rundel-tech/ZARC/software/Notes.txt

cpm         CP/M 2.2 files and my disk image file extractor.
cpm/bios    CP/M BIOS. Intended to be loaded from memory card.
cpm/cpm_dev CP/M programmes written by me.
cpm/img_to_files    Extracts CP/M files from disk images.
cpm3        CP/M 3 files.
includes    ZARC include files.
monitor     ZARC monitor program.
tools       zmac and ld80 assembler and linker plus scripts.
