rundel-tech/ZARC/hardware/HardwareNotes.odt

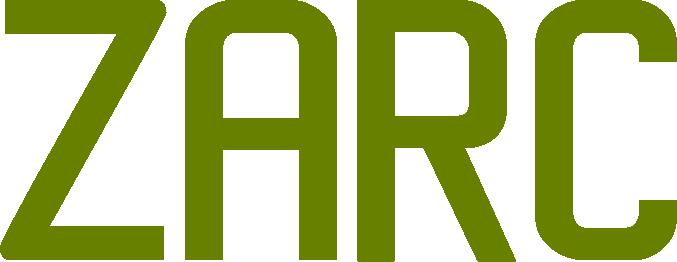
[picture p2: figure]
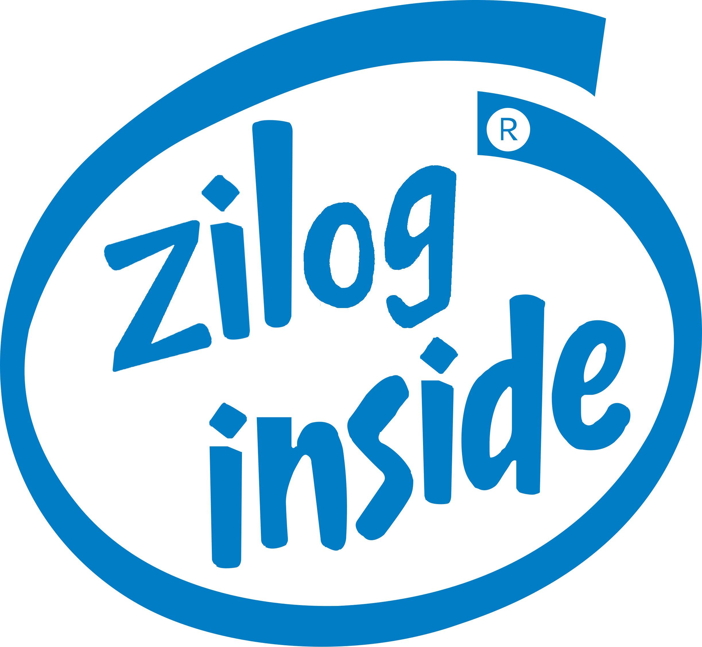
[picture p3: figure]

| ZARC HARDWARE DESIGN NOTES

Author: Merlin Skinner-Oakes

This is more of a log of the design process. See Users’ Guide for a description of the system as it stands.

# FRONT PANEL

Considering the DEC PDP-8/E, we have:

- SW - OMNIBUS SW line control. Influences some peripherals.
- Switch register bits 0 to 11.
- ADDR LOAD - sets PC to switch register
- EXTD ADDR LOAD - loads extended field information from SR6—11
- (START) CLEAR - clears the accumulator an other things, but not PC.
- (START) CONT - start machine running, or single step if SING STEP is down.
- EXAM - read current address and increment PC
- HALT - non biased, down is halted
- SING STEP
- DEP (biased down)

I think I'd need:

- Switch register bits 15 to 0
- ADDR LOAD - sets PC to switch register
- RESET - push
- FETCH - push
- STORE - push
- SINGLE - toggle - single step or run. Also affects fetch/store auto-increment.
- RUN - push
- STOP - push
- INT - push
- MEM/IO - toggle

# 11/2/2017

A simple idea. The front panel would look like this:

- 8 data switches
- Various mode switches
- Various status LEDs
- An "EXEC" momentary switch. This feeds an instruction (or data) to the CPU from the data switches.
- Address & date indicator LEDs

This would be a very flexible, but not so easy to use. To set the address to anything other than zero (reset), you would need to feed a "JMP" instruction or similar to the CPU. Hence we'd need to select 0xC3 on the switches, press EXEC, select the LSB, press EXEC then the MSB ... On the other hand, it would be a good debugging aid at a very low level.

Essentially this isn't so different to the Altair idea of loading the address by feeding a JMP to the CPU followed by the address. In this case, the 0xC3 was hard-coded. We could combine the two ideas by having the entire JMP instuction (24 bits) as switches. That's a lot of switches, though. It would mean that we couldn't inject 4-byte instructions, but that wouldn't be much of a limitation.

# 10/6/2017

Trying to get some idea of the case I'd require. Possibilities include:

- Farnell "Multicomp" G756AV (300 x 200 x 75 mm) - £17.01
- Farnell Pro-Power G17082UBK (431.8 x 203.2 x 86 mm) - £21.93

Both are available from Amazon slightly cheaper than Farnell.

To get a rough idea of size, I'd need at least 16 LEDs with switches underneath. Other switches could be in a second row.

Considering switch pitch. 15 mm seems reasonably "natural". Conventional keyboard pitch is about 18 to 19 mm. My PC keyboard appears to be about 18.9 mm pitch. My piano key pitch is 23.4 mm.

15 x piano pitch = 351 mm

15 x 18.9 = 283.5 mm

These rough measurements make the G756AV case look a little "cozy".

# 3/7/2017

CP/M can support up to 16 "banks", where the (usually) bottom 48 KBytes is paged with a common upper area. 16 x 64K is 1 MB. Looking in Farnell:

1562900 is a "AS6C4008-55PCN - SRAM, 4 Mbit, 512K x 8bit, 2.7V to 5.5V, DIP, 32 Pins, 55 ns"

Datasheet: https://www.alliancememory.com/wp-content/uploads/pdf/AS6C4008.pdf

Standby current: 4 μA (TYP.)!

We'd need two for a fully expanded system.

One possible idea is to page both 48K and 16K banks. CP/M would use a single 16K bank leaving fifteen of these for other purposes such as test areas, disk caches etc.

# 4/7/2017

This chip looks to do much of what I'd need, though I'd prefer to pull _WE and _OE high but it shouldn't really matter.

http://uk.farnell.com/analog-devices/adm691aanz/supervisor-circuit-mpu-1-dip-16/dp/2460086

Z80 Socket: http://uk.farnell.com/harwin/d2840-42/socket-ic-dil-40way-pk10/dp/1023063

# 5/7/2017

The upper 16K should be selectable from the 16 banks available, though for CP/M just one will be mapped permanently.

The remaining 48K should be selectable from the 16 banks and all are available to CP/M.

An alternate mode allows for any 16K bank to be mapped to the lower, or perhaps all four 16K banks of the Z80. This allows for initialisation on reset. Once running, the system can configure the memory as required.

On reset, the alternate mode is selected, mapping one of the 16K banks to the entire Z80 memory space. This facilitates startup code that is run on reset. Use of the 16K RAM banks allows this to be “hidden” from CP/M while allowing the full 16 x 48K pages to be accessible.

- Port n – lower (48K) RAM bank select (0 to 15)
- Port m – upper (16K) RAM bank select (0 to 15) plus overlay bit. Cleared on reset.

If the overlay bit is reset, the upper RAM bank is mapped to all four 16K Z80 spaces as “images”. In this case, port n contents are ignored.

# 9/7/2017

Interrupts and memory banks. I don't think we need to do anything special here. If we use a built-in vector, the software needs to maintain a copy in each of the banks. That's probably easier than a forced hardware bank selection. Having said that, the software could maintain a copy of the current bank in RAM, then use this to restore the state when the interrupt completes. This may conflict a bit with the "overlay bit" idea above so this may require further thought if I want to implement this.

Ideas for cases:

http://uk.rs-online.com/web/p/rack-fitting-cases-enclosures/0582877/ - ABS plastic

http://uk.rs-online.com/web/c/enclosures-storage-material-handling/19-inch-racking/rack-fitting-cases-enclosures/

http://uk.rs-online.com/web/p/rack-fitting-cases-enclosures/8104352/

# 13/10/2017

Front panel idea: Design panel for 16-bit address and data, though we’ll only be using the lowest 8 bits of data. Paging uses the same logic as the Z80 does, so the operator will need to write to the mapping register to access the entire memory. The advantages of this technique is that the panel will work for any CPU, and is probably simpler anyway than using the CPU as an address counter. It also means that the CPU and memory can be tightly coupled (with no intervening buffers) and hence fast if required.

Plan:

The front panel will have 16 address/data switches and its own address counter. If based on 74ls191 I have some already, though the '193 would be more convenient logically. The front panel switches would be something like:

- LAD (push) - Load ADdress
- + (push) - increment address
- - (push) - decrement address
- RD (push) - read location
- WR (push) - write locaton
- Mem / I/O (toggle) - memory / I/O space select

# 18/10/2017

Considering other switch types, such as On-Off-(On).

http://www.te.com/commerce/DocumentDelivery/DDEController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

The “F” series sound good. 6437630 is the core number for searching, variants have different prefixes and suffixes.

On-Off-(On) - 4-6437630-8 - £6.54

It all gets rather expensive. E-bay? Yes!

http://www.ebay.co.uk/itm/Momentary-On-Off-On-Mini-Small-Toggle-Switch-Car-Dash-SPDT-/281875674923

There are others of similar price. This could be handy for address inc/dec and read/write.

Memory mapping: 1 x 74ls670 could give us switching in 16 KB blocks. This would address up to 4 x 64 = 256 KB of memory in total. Conversely, adding a second ‘670 would allow up to 4 MB of memory, which may be a bit over the top.

Reset could be by means of disabling the ‘670 and forcing a constant onto the upper address bits (perhaps simply with resistors), until disabled in software.

# 6/12/2017

Considering 2 x 74hct374 (https://assets.nexperia.com/documents/data-sheet/74HC_HCT374_CNV.pdf) as paging registers.

- 3-state output enable time _OE to Q: 30 ns max. @ 25 °C
- 3-state output disable time _OE to Q: 30 ns max. @ 25 °C

One ‘374 represents the upper address bits for the lower 48 KB, and the other the upper 16 KB. Reset (and possibly interrupts) are catered for by disabling both registers and relying on pull-ups (or downs) to set the page until the software has initialised it properly.

OR

Use a single 8-bit register and a multiplexer (74hct157, https://assets.nexperia.com/documents/data-sheet/74HC_HCT157.pdf). This works out nicely as S can select upper 16 KB / lower 48 KB. _E forces all outputs low, so would be very handy for resets etc.

- S to nY – 25 ns max. @ 25 °C
- _E to nY – 23 ns max. @ 25 °C

OR

Use [1 or 2] x 74ls670 (still made by TI!) for very flexible mapping of each 16 Kb block to a [18 or 22]-bit address. This has the significant advantage that copies from one bank to another can be sped up by making them both “visible” at the same time.

- Read address to Q is 45 ns max.
- Read enable to Q is 40 ns max.

No “upper 16 KB/lower 48 KB detect” logic is required as we can use A14 & A15 directly. This will probably make this solution faster in overall propagation delay terms.

As above, the tri-state mode could be used for reset and perhaps interrupts. In the interrupt case, the previous page is maintained so we don’t need to be too clever with the software unless the interrupt routine requires access to something other than the default page. It is likely that the software would maintain a copy of the paging state in RAM in any case, so this may not be much of an issue.

# 2/5/2018 - Unusual Front Panel Idea

Rather than going for a more conventional address/data system, how about feeding data to the CPU from switches. Setting the address, for example, will require feeding the CPU a jump instruction followed by the address as if it were fetched from memory.

Controls are:

- 8 data - sets the corresponding data bit
- Clear - resets all data bits
- Run / Stop (toggle)
- Step - run one machine cycle (in stopped state)
- Data sel (toggle) - data fed to the CPU will be either from the switches or memory / I/O
- MemWrite - write switch data to memory at current address
- IOWrite - write switch data to I/O at current address
- NMI - non-maskable interrupt
- Reset - system reset (guarded?)

Notes

1. Data bus display shows memory or I/O data when data select is set to "normal". It shows the switch register data when set to "switches".
2. Machine stops at a M1 state (not an interrupt acknowledge) when "stop" is selected.

Writing to memory would involve:

- Set "Run / Stop" to "stop"
- Set "Data sel" to "Switches"
- Press "Clear"
- Set bits so data reads 0xc3 (JMP)
- Press "Step"
- Press "Clear"
- Set bits so data reads low byte of address
- Press "Step"
- Press "Clear"
- Set bits so data reads high byte of address
- Press "Step"
- Address bus shows the desired address.
- Press "Clear"
- Set bits so data as desired
- Press MemWrite (or IOWrite for I/O)

To select the next address, issue a "NOP":

- Press "Clear" (NOP is 0x00, so no data switches are required)
- Press "Step"

# 6/11/2018 (Tuesday)

How about ZARC – Z80 Advanced (Anachronistic?) Retro Computer?

# 27/7/2019 (Saturday)

To simplify the I/O, I have decided to implement it entirely within a Cyclone II FPGA development board. This device is limited to 3.3 V, however. As 74LVC245 devices (Farnell 1749756) are 5 V tolerant, these would form a nice easy bridge. My CMOS Z80 has a VIH of only 2.2 V (minimum), so there is plenty of margin with a 74LVC245 driven from 3.3 V.

# 30/7/2019 (Tuesday)

Video ideas:

- Use BBC Micro font expanded to 12 * 8 pixels. The original is here: https://damieng.com/blog/2011/02/20/typography-in-8-bits-system-fonts. This may help with any copyright issues as well as enhancing readability.
- Use video ram to contain cold boot code at power-on. Simple bootstrap code could read this, such as ld hl,0x0100; ld bc,00<port>; inir; halt. This gives up to 8 KB of bootstrap code! *1
- Rename DCClk to VRClk. It is convenient that this is a good speed for the video RAM. Odd cycles are for video, even for CPU / block copies etc.
- Hardware scrolling is automatically applied when the bottom line overflows.
- The hardware character cursor flashes the current location at about 1 Hz. This can be disabled in software.

*1 inir is limited to 256 bytes. One way around this is to use an initial loader that copies in the rest of the code. This should be plenty to do some BIST as well as boot from an MMC card.

# 14/1/2020 (Tuesday)

Super and Prot Bits

Implement a supervisor / user mode mechanism without adding much logic. The currently proposed system offers memory write protection in 16 KB blocks. This is reasonable protection against out-of-control or buggy software, but has obvious weaknesses. Nothing stops code writing to the memory mapping registers and disabling write protection, for example. In fact, all of the I/O is accessible to all software. This may cause issues if, for example, code written for another CP/M system is run on ZARC. Any I/O accesses by that code would have unknown effects on the completely different I/O architecture of ZARC.

The idea is that only 16 KB memory blocks with the "SUPER" bit (currently MA14) set would be allowed access to I/O. Each M1 cycle (instruction fetch), the SUPER bit is stored and acts as an I/O enable. Accesses to I/O when SUPER is low are blocked. By default, this results in a never-ending wait state and hence prevents system upset. The offending I/O address would be visible on the front panel. The step function of the front panel can be used to reveal the PC. Under software control, it is possible to modify this behaviour to prevent the system from being completely halted. In this alternate mode, I/O accesses are blocked as before, but the system is allowed to continue. An interrupt is generated to allow a supervising system to take the appropriate action. This is likely to be useful when running an operating system, so I/O functions such as disk accesses and console may be allowed to continue.

Writes to memory pages with the "PROT" bit set exhibit similar behaviour. By default, the system is halted. The offending address will then be visible on the front panel. Under software control, it is possible to modify this behaviour to prevent the system from being completely halted. In this alternate mode, offending writes are blocked as before, but the system is allowed to continue. An interrupt is generated to allow a supervising system to take the appropriate action.

The strategy is to simply halt the machine if something goes wrong until a monitor program or operating system is running. When running CP/M, only the upper 16 KB would normally have SUPER set. Hence user code is prevented from messing about with I/O other than through the BIOS. The BIOS runs in the upper 16 KB, and hence can access I/O.

Implementation could be the addition of a single flip-flop to capture the state of SUPER during an M1 cycle. The output of this is supplied to the FPGA, which includes this in the WAIT logic. Hence only one extra signal need cross the 5 V / 3 V domains.

# 18/3/2020 (Wednesday)

Wired clock generator circuit U7, U8 & U9. Measured Q10 of U9 and it was 30.517 Hz. This is exactly as calculated. Not bad for a probably 25 year old oscillator! Of course the meter ("Feedback FM610") is long out of calibration, but the correlation is remarkable.

Further to this, measuring U8 pin 3 (8 MHz) reads exactly 8.00000 MHz.

# 8/6/2020 (Monday)

I wired the two AA cells to the backup circuit a few days ago. After 2-3 days of no mains power, the capacitor voltage reads about 2.7 V. Voltage across the 220 Ohm battery series resistor is 6 mV, corresponding to a current of about 27 uA. Minimum backup voltage for the RAM is 1.5 V. That's a bit higher than I expected, but still very much OK.

For fun, I did some calculations in BackupSupply.ods. The battery life should be about 14 years at this consumption, but I'm sure other things will get to it first!

# Build

In the intervening period, the main board was built with a few changes along the way. The lockdown associated with COVID-19 certainly helped here.

# 19/2/2021 (Friday)

I've not made any hardware modifications for a long time. When I have been working on this, it is to add the MMC and RTC plus lots of software. Now CP/M runs! There are a few hardware modifications I am considering.

1) Change U43 to a CD74HCT373E (CPC part SC16201) to increase margins on switch inputs. Using an LS part here did not result in any issues, but this solution is better. Done.

2) Replace temporary D4 with a Schottky part (1N5817). Done.

3) Add a 1N5817 Schottky diode in series with D5 and D6 to reduce the brightness of the LEDs in DIM mode. Done.

4) Modify enables to MA<19..14> driver (U4) to disable it during I/O cycles, when the mapped address is not relevant. This simply moves U4 pin 1 from RFSH to _MREQ. Done.

5) Fix NEXT function. Relying on pull-down resistors on BD (U23) won't work because there are LS loads on the BD bus (74ls670). A better solution would be to switch SW_PD_COM with a transistor, thereby generating a 0x00 regardless of the data switch settings. Done.

# 24/4/2021 (Saturday)

Considering changes to the I/O FPGA. Two ideas are under consideration:

1. Hardware CRC. The primary purpose is to speed up memory card I/O.
2. NMI is currently not useable in CP/M mode as CP/M uses the vector (0x0066) as part of default FCB 1. A solution would be useful to avoid crashes if the NMI features are used.

## Hardware CRC

This would be relatively straightforward, and would take up only a small part of the FPGA. There is some advantage to keeping this separate from the memory card I/O system so it may be used for other applications within ZARC. Essentially, from a software point of view, the current monitor crc16x (CRC-16 – XMODEM) function call would be replaced by a single OUT instruction. However, it would not offer any advantage over the present implementation beyond speeding up memory card I/O. It is something to consider when next making changes to the FPGA.

## NMI Memory Mapping (Idea)

It is unfortunate that CP/M overwrites the NMI vector. This makes the PROT, SUPER, trace and front panel NMI switch all unusable when CP/M is running. Worse, any NMI will cause a jump to the unpredictable contents of FCB and therefore almost certainly cause a crash. One way to avoid this would be to select a different page when the NMI is serviced. This is not straightforward. There are two main issues as I see it:

1. Detection of NMI processing (interrupt acknowledge).
2. Control of memory paging logic.

The Z80 generates a clearly distinguishable acknowledge cycle for interrupts (_IORQ with _M1). Unfortunately, this is not true for NMI. The acknowledge cycle is simply a normal instruction fetch, but with the memory contents discarded. However, since an NMI is always actioned at the end of the instruction in which it occurs, careful timing of the assertion of NMI with respect to M1 cycles should enable the logic to ascertain which cycle is currently in progress.

The FPGA cannot change the memory mapping, only enable or disable it (the _MMAP_EN signal). Disabling the mapping forces the page is use to be 0x3f for all four banks. Write protection is also active in this state. Any solution must allow the saving of the PC on the stack to proceed unmolested.

The Z80’s response to an NMI is to stack the PC, then fetch the first instruction of the NMI handler from address 0x0066 (http://www.z80.info/zip/z80-interrupts_rewritten.pdf section 3).

Considering one possible scheme:

1. Synchronise the assertion of NMI with the current machine cycle state so that the NMI is actioned at a predictable point.
2. Enable memory mapping for writes, but disable it for reads. Execution proceeds from page 0x3f location 0x0066, but writes go to the application-selected page. This permits the two stack writes (PC) plus any PUSH instructions to proceed uninhibited.
3. Software sets up the monitor memory map, moves the stack to the monitor’s variables page and enables normal memory mapping operation.

The NMI handler must take care to save all relevant context information while protecting its environment. A candidate NMI handler may start like this:

; Jump at 0x0066 goes here. Writes will go to the application-selected bank

; until normal operation is selected in this code. We should try to minimise

; writes until this point as it will go on the application stack.

default_nmi push af ; To application stack

; Save memory mapping context before we change anything.

in IOA_MMAP_0

ld (user_mmap_0), a

in IOA_MMAP_1

ld (user_mmap_1), a

in IOA_MMAP_2

ld (user_mmap_2), a

in IOA_MMAP_3

ld (user_mmap_3), a

; Setup bank 0 and bank 1 for the monitor.

; Set bank 0 (0x0000 to 0x3fff) as read-only with I/O access.

ld a, MMAP_MON_B0_PAGE + MMAP_PROT_MASK + MMAP_SUPER_MASK

out (IOA_MMAP_0), a

; Bank 1 (0x4000 to 0x7fff) writeable.

ld a, MMAP_MON_B1_PAGE

out (IOA_MMAP_1), a

; Enable normal memory mapping. This disables the NMI mode read / write

; differentiation in operation until now.

ld a, SYSCTRL_MMAP_MASK

out (IOA_CONTROL), a

; Set stack to exception area so we can save the registers.

ld (user_sp), SP ; Save SP

ld SP, XPT_STACK_TOP + 1

[ Save CPU registers. PC and AF will require some work as these are on the user

stack on an arbitrary location.]

A running CP/M system could reasonably locate the stack in any of the four banks at some point. It should be possible to handle this and allow debugging of any bank using the proposed system. This would allow debugging of any part of the CP/M system, for example.

While making these changes, it would seem reasonable to modify the monitor to use just two banks (0 and 1). The proposed memory mapping is therefore:

; 0 (0000 - 3FFF): 3f read only, supervisor - monitor program

; 1 (4000 - 7FFF): 3e writeable - monitor variables, buffers etc.

; 2 (8000 - BFFF): (not used)

; 3 (C000 - FFFF): (not used)

The complications caused by interrupts make it sensible to only allow these in user code. This allows the monitor to be free of common banks with the user code. Simplifying its operating environment may improve reliability too.

The above code also assumes a change to the system control register (IOA_CONTROL) register. At the moment, we have (from io_map.i):

BITDEF SYSCTRL_MMAP, 0 ; “1” enables memory mapping

BITDEF SYSCTRL_TRARM, 1 ; “1” arms the trace interrupt

Add a single extra bit:

BITDEF SYSCTRL_NMI_MAP, 2 ; NMI mode memory mapping

This is set by hardware on NMI, and reset by software to restore normal operation.

# 9/6/2021 (Wednesday)

I have implemented something akin to the context switching ideas discussed in the previous entry. This allows debugging without the debugger appearing in the Z80 memory space of the target programme. There are limitations, of course, but this will allow debugging of any part of CP/M or a transient programme running under it.

Using the new technique allows the monitor to load an entire 64 K from the memory card. To achieve this requires something like:

> set mmap 1 ; If not already enabled

> map

0 (0000 - 3FFF): 00 writeable ; Map should look like this

1 (4000 - 7FFF): 01 writeable

2 (8000 - BFFF): 02 writeable

3 (C000 - FFFF): 03 writeable

> readsec 0 128 0

> dump 0 ; Reasonableness check

0000 FA B8 00 10 8E D0 BC 00 |........|

0008 B0 B8 00 00 8E D8 8E C0 |........|

0010 FB BE 00 7C BF 00 06 B9 |...|....|

0018 00 02 F3 A4 EA 21 06 00 |.....!..|

0020 00 BE BE 07 38 04 75 0B |....8.u.|

0028 83 C6 10 81 FE FE 07 75 |.......u|

0030 F3 EB 16 B4 02 B0 01 BB |........|

0038 00 7C B2 80 8A 74 01 8B |.|...t..|

The read takes about ten seconds in all. This currently uses a software CRC for the data transfers. There are other inefficiencies, such as copying involved in maintaining the cache and between memory spaces.

As changes to the FPGA were required to implement the new NMI and context switching mechanisms, it seemed a good time to add a hardware CRC block. Using the hardware CRC, the above 64 KB load is achieved in 8.5 seconds. Further improvements could be achieved by optimising the SPI transfer code, which is currently not optimised for speed.

Note for both of the measurements above, the cache was effectively flushed beforehand by reading sectors outside of the test range:

> readsec 256 128 0

# 26/6/2021 (Saturday)

The intended behaviour of the MMC interface was to initialise at 250 kHz, then switch to 4 MHz for normal operation. While looking at ways to optimise the sector read code (read_block in mmc.z80), I discovered a bug that prevented the switch to higher speed, so we were running at 250 kHz throughout. Fixing this bug caused errors during initialisation. Further reading of the MMC specification reveals that 400 kHz is the maximum speed in “Identification Mode (OD)”. The only way to switch from identification mode to data transfer mode is with “CMD 3” (SET_RELATIVE_ADDR), which is not available in SPI mode. It would appear, therefore, that 400 kHz is the maximum speed we can use, and would explain the errors encountered when operating at 4 MHz.

I plan to modify the FPGA firmware to run at 400 kHz in slow mode even though I doubt this will make much difference to the system performance as a whole. High speed mode may yet be useful for future peripherals and doesn’t involve much extra logic, so I will leave that alone.

Playing with figures in Calculations.ods reveals that even at 250 kHz the maximum theoretical loading time for 64 KB would be about 2.4 seconds, though this makes no allowance for command transfers, copying from cache and other overheads. At 400 kHz this reduces to 1.4 seconds. Either is plenty fast enough for ZARC and definitely faster than floppy disks due in part to much lower overheads (track stepping etc.).

# 29/6/2021 (Tuesday)

I have changed the FPGA to run SPI at 400 kHz in slow mode. The read_block code in mmc.z80 has been updated to allow processing and SPI interface to run in parallel. Now a 64 KB read (readsec 0 128 0) takes about 6.4 seconds from the monitor. This was originally ten. I suspect a good part of this time is the monitor copy code and status messages. Copying from cache to memory is particularly inefficient as the appropriate page and mapping is carried out for each and every byte. This could clearly be improved, but transfer speed in the monitor is not a priority. CP/M disk logging seems noticeably faster, however.
