rundel-tech/ZARC/fpga/Pinout.ods

Demo Board Pinout
P1 | FPGA pin | FPGA Signal | Bank | Demo Board | ZARC Signal
1 | 40 | DEV_OE / IO | 4 |  | N/C
2 | 41 | IO | 4 |  | LV_D1
3 | 42 | IO | 4 |  | LV_D0
4 | 43 | IO | 4 |  | LV_D3
5 | 44 | IO | 4 |  | LV_D2
6 | 45 | IO | 4 |  | LV_D5
7 | 47 | IO | 4 |  | LV_D4
8 | 48 | IO | 4 |  | LV_D7
9 | 51 | IO | 4 |  | LV_D6
10 | 52 | IO | 4 |  | LV_A1
11 | 53 | IO | 4 |  | LV_A0
12 | 55 | IO | 4 |  | LV_A3
13 | 57 | IO | 4 |  | LV_A2
14 | 58 | IO | 4 |  | LV_A5
15 | 59 | IO | 4 |  | LV_A4
16 | 60 | IO | 4 |  | LV_A7
17 | 63 | IO | 4 |  | LV_A6
18 | 64 | IO | 4 |  | \_LV_M1\_
19 | 65 | IO | 4 |  | \_LV_IORQ\_
20 | 67 | IO | 4 |  | \_LV_MREQ\_
21 | 69 | IO | 4 |  | \_LV_WR\_
22 | 70 | IO | 4 |  | \_LV_RD\_
23 | 71 | IO | 4 |  | LV_SUPER
24 | 72 | IO | 4 |  | LV_PROT
25 | GND |  |  |  | GND
26 | GND |  |  |  | GND
27 | VCC3.3 |  |  |  | P3V3
28 | VCC3.3 |  |  |  | P3V3
P2 | FPGA pin | FPGA Signal | Bank |  | ZARC Signal
1 | GND |  |  |  | GND
2 | GND |  |  |  | GND
3 | 73 | IO | 3 | R13/C14 network | N/C
4 | 74 | IO | 3 |  | N/C
5 | 75 | IO | 3 |  | \_LV_NMI_SWITCH\_
6 | 76 | nCEO | 3 |  | N/C
7 | 79 | IO | 3 |  | LV_RESET
8 | 80 | IO | 3 | GND via R9 [0Ω] | N/C
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
