rundel-tech/ZARC/hardware/BackupSupply.ods

Supercapacitor Charging
Assuming a charge from 12 V via a resistor, to avoid the diode drop from the 5 V supply.
1 | Capacitor value (F)
12 | Charging source voltage
5 | Nominal capacitor voltage
0.65 | Diode drop in charging circuit
1000 | Charging resistor
0.01135 | Initial charge current
0.00635 | Terminal charge current
0.00885 | Average charging current
5 | Capacitor charge (Coulombs)
564.971751412429 | Charging time (s)
9.41619585687382 | Above in minutes
0.1288225 | Initial power dissipation in resistor (W)
0.0403225 | Terminal power dissipation in resistor (W)
12.5 | Energy stored (J)
Discharging
0.425 | DS1672 VBACKUP Current (Oscillator On) (µA typical)
4 | AS6C4008-55PCN static RAM (µA typical)
2 | MCP1702 3.3 V regulator (µA typical)
1 | Supercapacitor leakage (4 µA typical for a similar type, or 1 µA/F at room temperature "rule of thumb")
0.008 | 1n4148 diode leakage at 25 °C
11.441 | Total (µA typical)
1.1441E-05 | Above in A
1.5 | Minimum backup voltage. RTC will run down to 1.3 V
1.5 | Charge left at this voltage
3.5 | Useable charge (Coulombs)
305917.314920024 | Backup time in s
5098.62191533374 | Above in minutes
84.977031922229 | Above in hours
3.54070966342621 | Above in days
27 | Current draw measured on 8/6/2020. RTC not fitted yet, so just the RAM and regulator etc. (µA)
2.7E-05 | Above in A
Battery Life
Cells are “Duracell Plus Power”
Found a datasheet here: https://images-eu.ssl-images-amazon.com/images/I/91w564JQWRS.pdf
650 | hours at 5mA load (the lowest load they specify) to 0.8 V
2340000 | Above in s
0.005 | 5 mA in A
11700 | Charge (Coulombs)
433333333.333333 | Seconds of life at current measured on 8/6/2020
7222222.22222222 | Above in minutes
120370.37037037 | Above in hours
5015.43209876543 | Above in days
13.7409098596313 | Above in years
