rundel-tech/ZARC/hardware/Calculations.ods

Reset time constant
This is very approximate as I haven’t looked up the 74hc14 thresholds.
1 | C in μF
1E-09 | Above in F
10000 | R
1E-05 | Time constant (s)
10 | Above in μs
CPU Cycle Timings
CPU is a Z84C0010PEG (10 MHz)
Datasheet Parameter | Value (ns) | Description
 | 55 | RAM access time (ns)
8 | 55 | Clock fall to _MREQ fall delay (max.)
17 | 20 | _Wait setup to clock fall (min.)
18 | 10 | _Wait hold after clock fall (min.)
27 | 50 | Clock rise to _IORQ fall (max.)
51 | 55 | Clock fall to _IORQ fall delay (max.)
15 | 25 | Data setup to clock rise (min.)
25 | 25 | Data setup to clock fall during M2, M3, M4 or M5 cycles (min.)
10 MHz | 8 MHz | 4 MHz
100 | 125 | 250 | Clock period (ns)
25 | 50 | 175 | _MREQ fall to _WAIT setup (M1 cycle or mem. R/W)
80 | 117.5 | 305 | _IORQ fall to _WAIT setup (I/O cycle)
25 | 50 | 175 | _IORQ fall to _WAIT setup (interrupt acknowledge cycle)
70 | 107.5 | 295 | _MREQ fall to data setup (M1 cycle)
15 | 52.5 | 240 | Above less RAM access time (decoding time)
120 | 170 | 420 | _MREQ fall to data setup (memory read cycle)
65 | 115 | 365 | Above less RAM access time (decoding time)
175 | 237.5 | 550 | _IORQ fall to data setup (I/O read cycle)
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
