rundel-tech/ZARC/hardware/FrontPanel/FrontPanel.ods

Considering the size of the front panel
25.4 | mm per inch
46 | Panel height (internal)
378 | Panel width (internal). This allows for the handles etc.
Switches
23.5 | Typical piano key spacing (mm)
22.86 | Switch spacing (multiple of 0.1”)
5 | Space at each end
17.0979877515311 | Switches per row (maximum)
Count | Type | Legend(s) | Function
8 | Toggles | D7 – D0 | 8 data bits
1 | Toggle | Man / Norm | Data sel (toggle) - data fed to the CPU will be either from the switches or memory / I/O
1 | Push | Write | Write - write switch data to memory at current address (memory or I/O)
1 | Push | Next | As below, but feeds a NOP to the CPU to increment the address
1 | Push | Step | Step - run one machine cycle (in stopped state)
1 | Toggle | Run / Stop | Run / Stop
1 | Push | NMI | NMI - non-maskable interrupt
1 | Push | Reset | Reset - system reset
15 | Number of switches
330.04 | Total space required if all were in a line.
LEDs
22.86 | LED spacing
5 | Space at each end
16.0979877515311 | LEDs per row (maximum)
Count | Legend(s) | Function
16 | A15 – A0
7 | MA20 – MA14 | Mapped address
1 | PROT | Write protection
8 | D7 – D0
1 | RESET
1 | HALT
1 | NMI
1 | INT
1 | M1
1 | MREQ
1 | IORQ
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
