rundel-tech/ZARC/software/cpm/cpm_dev/fsck/README.md

# CP/M File System Consistency Checker
“FSCK” is an abbreviation for File System Consistency checK), as commonly found on Unix and Linux systems. This programme scans a CP/M 2.2 or CP/M 3 file system and reports any errors it finds. It does not attempt any kind of repair. Though written for my ZARC retro-computer project, this should run on any CP/M system. Simply copy [FSCK.COM](FSCK.COM) to a disk and run it. For further information, see [fsckGuide.pdf](fsckGuide.pdf).
