rundel-tech/ZARC/hardware/FrontPanel/Panel.png

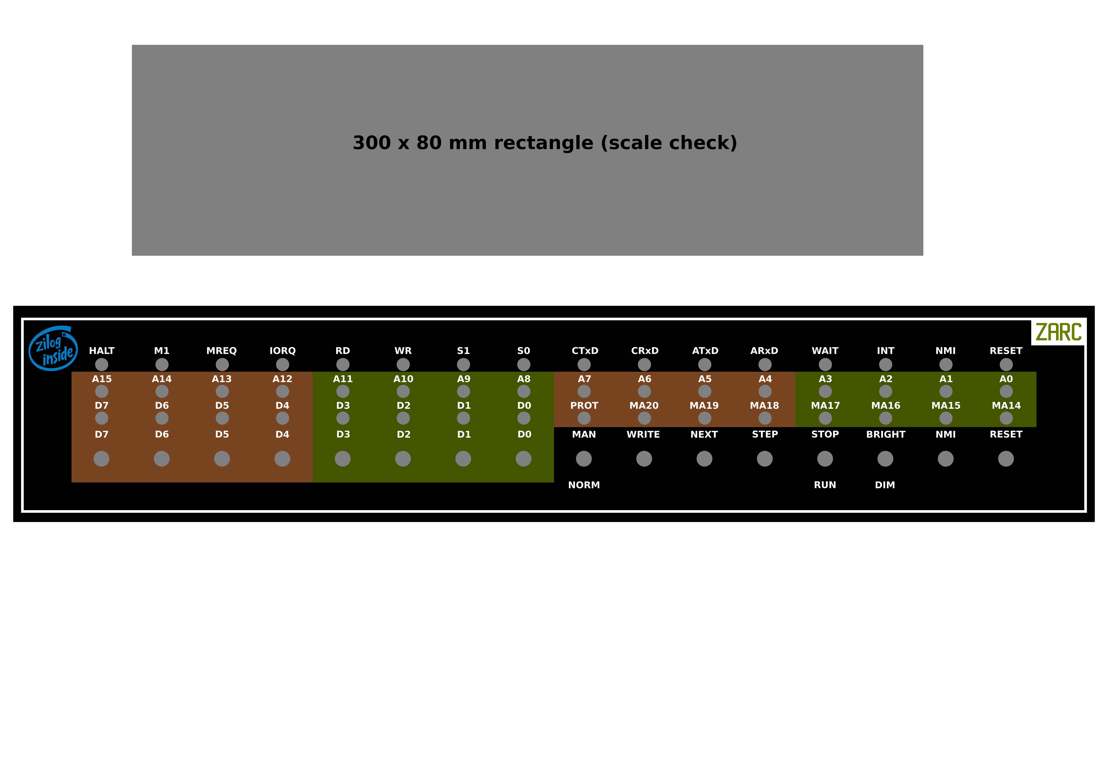
hardware/FrontPanel/Panel.png
