rundel-tech/ZARC/hardware/CAD/Main/Archive/netlist_wired.ods

Tracking Wiring Progress
18/04/20 |  | Merlin Skinner
Imported from “netlist.txt”
0 | Number of nets yet to be wired
353 | Number of wired nets
100.00% | Nets complete
1065 | Total nodes
0 | Number of nodes yet to be wired
100.00% | Nodes complete
 |  | START | nets
State | Not Conn. | Name | Count | To Do
Done | N/C | unnamed_net151 | 1 | 0 | J1 | B7
Done | N/C | unnamed_net150 | 1 | 0 | J1 | B5
Done | N/C | unnamed_net149 | 1 | 0 | J1 | B3
Done | N/C | unnamed_net148 | 1 | 0 | J1 | A5
Done | N/C | unnamed_net147 | 1 | 0 | J1 | A3
Done | N/C | unnamed_net146 | 1 | 0 | J1 | B6
Done | N/C | unnamed_net145 | 1 | 0 | J1 | B4
Done | N/C | unnamed_net144 | 1 | 0 | J1 | B2
Done | N/C | unnamed_net143 | 1 | 0 | J1 | A6
Done | N/C | unnamed_net142 | 1 | 0 | J1 | A4
Done | N/C | unnamed_net141 | 1 | 0 | J1 | A2
Done |  | LV_A7 | 2 | 0 | J1 | B31, | U33 | 11
Done |  | LV_A6 | 2 | 0 | J1 | A31, | U33 | 12
Done |  | LV_A5 | 2 | 0 | J1 | B30, | U33 | 13
Done |  | LV_A4 | 2 | 0 | J1 | A30, | U33 | 14
Done |  | LV_A3 | 2 | 0 | J1 | B29, | U33 | 15
Done |  | LV_A2 | 2 | 0 | J1 | A29, | U33 | 16
Done |  | LV_A1 | 2 | 0 | J1 | B28, | U33 | 17
Done |  | LV_A0 | 2 | 0 | J1 | A28, | U33 | 18
Done |  | LV_PROT | 2 | 0 | J1 | A19, | U13 | 11
Done |  | LV_SUPER | 2 | 0 | J1 | A18, | U13 | 12
Done |  | \_LV_WR\_ | 2 | 0 | J1 | A17, | U13 | 13
Done |  | \_LV_RD\_ | 2 | 0 | J1 | A16, | U13 | 14
Done |  | \_LV_IORQ\_ | 2 | 0 | J1 | A15, | U13 | 15
Done |  | \_LV_MREQ\_ | 2 | 0 | J1 | A14, | U13 | 16
Done |  | \_LV_M1\_ | 2 | 0 | J1 | A13, | U13 | 17
Done |  | LV_CPU_CLK | 2 | 0 | J1 | A11, | U13 | 18
Done |  | unnamed_net140 | 2 | 0 | R57 | 1, | U3 | 11
Done |  | unnamed_net139 | 2 | 0 | R53 | 1, | U3 | 12
Done |  | unnamed_net138 | 2 | 0 | R56 | 1, | U3 | 13
Done |  | unnamed_net137 | 2 | 0 | R52 | 1, | U3 | 14
Done |  | unnamed_net136 | 2 | 0 | R55 | 1, | U3 | 15
Done |  | unnamed_net135 | 2 | 0 | R51 | 1, | U3 | 16
Done |  | unnamed_net134 | 2 | 0 | R54 | 1, | U3 | 17
Done |  | unnamed_net133 | 2 | 0 | R50 | 1, | U3 | 18
Done |  | unnamed_net132 | 2 | 0 | R49 | 1, | U2 | 11
Done |  | unnamed_net131 | 2 | 0 | R45 | 1, | U2 | 12
Done |  | unnamed_net130 | 2 | 0 | R48 | 1, | U2 | 13
Done |  | unnamed_net129 | 2 | 0 | R44 | 1, | U2 | 14
Done |  | unnamed_net128 | 2 | 0 | R47 | 1, | U2 | 15
Done |  | unnamed_net127 | 2 | 0 | R43 | 1, | U2 | 16
Done |  | unnamed_net126 | 2 | 0 | R46 | 1, | U2 | 17
Done |  | unnamed_net125 | 2 | 0 | R42 | 1, | U2 | 18
Done |  | unnamed_net124 | 2 | 0 | R41 | 1, | U1 | 11
Done |  | unnamed_net123 | 2 | 0 | R37 | 1, | U1 | 12
Done |  | unnamed_net122 | 2 | 0 | R40 | 1, | U1 | 13
Done |  | unnamed_net121 | 2 | 0 | R36 | 1, | U1 | 14
Done |  | unnamed_net120 | 2 | 0 | R39 | 1, | U1 | 15
Done |  | unnamed_net119 | 2 | 0 | R35 | 1, | U1 | 16
Done |  | unnamed_net118 | 2 | 0 | R38 | 1, | U1 | 17
Done |  | unnamed_net117 | 2 | 0 | R34 | 1, | U1 | 18
Done |  | \_S0\_ | 2 | 0 | R61 | 2, | U1 | 9
Done |  | \_S1\_ | 2 | 0 | R61 | 3, | U1 | 8
Done |  | LED_D0 | 2 | 0 | R50 | 2, | J2 | 26
Done |  | LED_D1 | 2 | 0 | R54 | 2, | J2 | 25
Done |  | LED_D2 | 2 | 0 | R51 | 2, | J2 | 24
Done |  | LED_D3 | 2 | 0 | R55 | 2, | J2 | 23
Done |  | LED_D4 | 2 | 0 | R52 | 2, | J2 | 22
Done |  | LED_D5 | 2 | 0 | R56 | 2, | J2 | 21
Done |  | LED_D6 | 2 | 0 | R53 | 2, | J2 | 20
Done |  | LED_D7 | 2 | 0 | R57 | 2, | J2 | 19
Done |  | LED_A8 | 2 | 0 | R42 | 2, | J2 | 18
Done |  | LED_A9 | 2 | 0 | R46 | 2, | J2 | 17
Done |  | LED_A10 | 2 | 0 | R43 | 2, | J2 | 16
Done |  | LED_A12 | 2 | 0 | R44 | 2, | J2 | 15
Done |  | LED_A13 | 2 | 0 | R48 | 2, | J2 | 14
Done |  | LED_A14 | 2 | 0 | R45 | 2, | J2 | 13
Done |  | LED_A15 | 2 | 0 | R49 | 2, | J2 | 12
Done |  | LED_A11 | 2 | 0 | R47 | 2, | J2 | 11
Done |  | LED_S0 | 2 | 0 | R41 | 2, | J2 | 10
Done |  | LED_S1 | 2 | 0 | R37 | 2, | J2 | 9
Done |  | LED_WR | 2 | 0 | R40 | 2, | J2 | 8
Done |  | LED_RD | 2 | 0 | R36 | 2, | J2 | 7
Done |  | LED_IORQ | 2 | 0 | R39 | 2, | J2 | 6
Done |  | LED_MREQ | 2 | 0 | R35 | 2, | J2 | 5
Done |  | LED_M1 | 2 | 0 | R38 | 2, | J2 | 4
Done |  | LED_HALT | 2 | 0 | R34 | 2, | J2 | 3
Done |  | unnamed_net116 | 2 | 0 | R24 | 1, | U5 | 11
Done |  | unnamed_net115 | 2 | 0 | R20 | 1, | U5 | 12
Done |  | unnamed_net114 | 2 | 0 | R23 | 1, | U5 | 13
Done |  | unnamed_net113 | 2 | 0 | R19 | 1, | U5 | 14
Done |  | unnamed_net112 | 2 | 0 | R22 | 1, | U5 | 15
Done |  | unnamed_net111 | 2 | 0 | R18 | 1, | U5 | 16
Done |  | unnamed_net110 | 2 | 0 | R21 | 1, | U5 | 17
Done |  | unnamed_net109 | 2 | 0 | R17 | 1, | U5 | 18
Done |  | unnamed_net108 | 2 | 0 | R16 | 1, | U4 | 11
Done |  | unnamed_net107 | 2 | 0 | R12 | 1, | U4 | 12
Done |  | unnamed_net106 | 2 | 0 | R15 | 1, | U4 | 13
Done |  | unnamed_net105 | 2 | 0 | R11 | 1, | U4 | 14
Done |  | unnamed_net104 | 2 | 0 | R14 | 1, | U4 | 15
Done |  | unnamed_net103 | 2 | 0 | R10 | 1, | U4 | 16
Done |  | unnamed_net102 | 2 | 0 | R13 | 1, | U4 | 17
Done |  | unnamed_net101 | 2 | 0 | R9 | 1, | U4 | 18
Done |  | unnamed_net100 | 2 | 0 | R32 | 1, | U6 | 11
Done |  | unnamed_net99 | 2 | 0 | R28 | 1, | U6 | 12
Done |  | unnamed_net98 | 2 | 0 | R31 | 1, | U6 | 13
Done |  | unnamed_net97 | 2 | 0 | R27 | 1, | U6 | 14
Done |  | unnamed_net96 | 2 | 0 | R30 | 1, | U6 | 15
Done |  | unnamed_net95 | 2 | 0 | R26 | 1, | U6 | 16
Done |  | unnamed_net94 | 2 | 0 | R29 | 1, | U6 | 17
Done |  | unnamed_net93 | 2 | 0 | R25 | 1, | U6 | 18
Done |  | \_ARxD\_ | 2 | 0 | R33 | 6, | U6 | 5
Done |  | \_ATxD\_ | 2 | 0 | R33 | 7, | U6 | 4
Done |  | \_CRxD\_ | 2 | 0 | R33 | 8, | U6 | 3
Done |  | \_CTxD\_ | 2 | 0 | R33 | 9, | U6 | 2
Done |  | LED_RESET | 2 | 0 | R32 | 2, | J3 | 24
Done |  | LED_NMI | 2 | 0 | R28 | 2, | J3 | 23
Done |  | LED_INT | 2 | 0 | R31 | 2, | J3 | 22
Done |  | LED_WAIT | 2 | 0 | R27 | 2, | J3 | 21
Done |  | LED_ARxD | 2 | 0 | R30 | 2, | J3 | 20
Done |  | LED_ATxD | 2 | 0 | R26 | 2, | J3 | 19
Done |  | LED_CRxD | 2 | 0 | R29 | 2, | J3 | 18
Done |  | LED_CTxD | 2 | 0 | R25 | 2, | J3 | 17
Done |  | LED_A0 | 2 | 0 | R17 | 2, | J3 | 16
Done |  | LED_A1 | 2 | 0 | R21 | 2, | J3 | 15
Done |  | LED_A2 | 2 | 0 | R18 | 2, | J3 | 14
Done |  | LED_A3 | 2 | 0 | R22 | 2, | J3 | 13
Done |  | LED_A4 | 2 | 0 | R19 | 2, | J3 | 12
Done |  | LED_A5 | 2 | 0 | R23 | 2, | J3 | 11
Done |  | LED_A6 | 2 | 0 | R20 | 2, | J3 | 10
Done |  | LED_A7 | 2 | 0 | R24 | 2, | J3 | 9
Done |  | LED_MA14 | 2 | 0 | R9 | 2, | J3 | 8
Done |  | LED_MA15 | 2 | 0 | R13 | 2, | J3 | 7
Done |  | LED_MA16 | 2 | 0 | R10 | 2, | J3 | 6
Done |  | LED_MA17 | 2 | 0 | R14 | 2, | J3 | 5
Done |  | LED_MA18 | 2 | 0 | R11 | 2, | J3 | 4
Done |  | LED_MA19 | 2 | 0 | R15 | 2, | J3 | 3
Done |  | LED_SUPER | 2 | 0 | R12 | 2, | J3 | 2
Done |  | LED_PROT | 2 | 0 | R16 | 2, | J3 | 1
Done |  | unnamed_net92 | 2 | 0 | U15 | 10, | U15 | 11
Done |  | unnamed_net91 | 2 | 0 | U15 | 4, | U15 | 3
Done |  | unnamed_net90 | 3 | 0 | U14 | 10, | U15 | 2, | R7 | 2
Done |  | unnamed_net89 | 4 | 0 | U32 | 3, | U15 | 12, | U15 | 1, | R6 | 2
Done |  | PROT | 4 | 0 | U13 | 9, | U4 | 9, | R8 | 9, | U25 | 6
Done |  | SUPER | 4 | 0 | U13 | 8, | U4 | 8, | R8 | 8, | U25 | 7
Done |  | unnamed_net88 | 3 | 0 | U14 | 8, | U25 | 4, | U24 | 4
Done |  | unnamed_net87 | 3 | 0 | U14 | 6, | U25 | 5, | U24 | 5
Done |  | unnamed_net86 | 3 | 0 | U14 | 4, | U25 | 13, | U24 | 13
Done |  | unnamed_net85 | 3 | 0 | U14 | 2, | U25 | 14, | U24 | 14
Done | N/C | unnamed_net84 | 1 | 0 | U34 | 23
Done |  | \_HALT\_ | 4 | 0 | R61 | 9, | U1 | 2, | U32 | 2, | U34 | 18
Done |  | A15 | 4 | 0 | R59 | 9, | U2 | 9, | U14 | 9, | U34 | 5
Done |  | A14 | 4 | 0 | R59 | 8, | U2 | 8, | U14 | 5, | U34 | 4
Done |  | A13 | 5 | 0 | R59 | 7, | U2 | 7, | U14 | 11, | U15 | 13, | U34 | 3
Done |  | \_RAM_CS1\_ | 2 | 0 | U15 | 6, | U36 | 22
Done |  | MA19 | 5 | 0 | U4 | 7, | R8 | 7, | U25 | 9, | U36 | 1, | U35 | 1
Done |  | MA18 | 5 | 0 | U4 | 6, | R8 | 6, | U25 | 10, | U36 | 30, | U35 | 30
Done |  | MA17 | 5 | 0 | U4 | 5, | R8 | 5, | U24 | 6, | U36 | 2, | U35 | 2
Done |  | MA16 | 5 | 0 | U4 | 4, | R8 | 4, | U24 | 7, | U36 | 31, | U35 | 31
Done |  | D3 | 6 | 0 | U23 | 5, | R60 | 5, | U3 | 5, | U34 | 8, | U36 | 17, | U35 | 17
Done |  | D4 | 6 | 0 | U23 | 6, | R60 | 6, | U3 | 6, | U34 | 7, | U36 | 18, | U35 | 18
Done |  | D5 | 6 | 0 | U23 | 7, | R60 | 7, | U3 | 7, | U34 | 9, | U36 | 19, | U35 | 19
Done |  | D6 | 6 | 0 | U23 | 8, | R60 | 8, | U3 | 8, | U34 | 10, | U36 | 20, | U35 | 20
Done |  | D7 | 6 | 0 | U23 | 9, | R60 | 9, | U3 | 9, | U34 | 13, | U36 | 21, | U35 | 21
Done |  | \_RAM_CS0\_ | 2 | 0 | U15 | 8, | U35 | 22
Done |  | A10 | 5 | 0 | R59 | 4, | U2 | 4, | U34 | 40, | U36 | 23, | U35 | 23
Done |  | A11 | 5 | 0 | R59 | 5, | U2 | 5, | U34 | 1, | U36 | 25, | U35 | 25
Done |  | A9 | 5 | 0 | R59 | 3, | U2 | 3, | U34 | 39, | U36 | 26, | U35 | 26
Done |  | A8 | 5 | 0 | R59 | 2, | U2 | 2, | U34 | 38, | U36 | 27, | U35 | 27
Done |  | MA14 | 5 | 0 | U4 | 2, | R8 | 2, | U24 | 10, | U36 | 28, | U35 | 28
Done |  | D2 | 6 | 0 | U23 | 4, | R60 | 4, | U3 | 4, | U34 | 12, | U36 | 15, | U35 | 15
Done |  | D1 | 6 | 0 | U23 | 3, | R60 | 3, | U3 | 3, | U34 | 15, | U36 | 14, | U35 | 14
Done |  | D0 | 6 | 0 | U23 | 2, | R60 | 2, | U3 | 2, | U34 | 14, | U36 | 13, | U35 | 13
Done |  | A0 | 7 | 0 | U33 | 2, | R58 | 2, | U5 | 2, | U14 | 1, | U34 | 30, | U36 | 12, | U35 | 12
Done |  | A1 | 7 | 0 | U33 | 3, | R58 | 3, | U5 | 3, | U14 | 3, | U34 | 31, | U36 | 11, | U35 | 11
Done |  | A2 | 6 | 0 | U33 | 4, | R58 | 4, | U5 | 4, | U34 | 32, | U36 | 10, | U35 | 10
Done |  | A3 | 6 | 0 | U33 | 5, | R58 | 5, | U5 | 5, | U34 | 33, | U36 | 9, | U35 | 9
Done |  | A4 | 6 | 0 | U33 | 6, | R58 | 6, | U5 | 6, | U34 | 34, | U36 | 8, | U35 | 8
Done |  | A5 | 6 | 0 | U33 | 7, | R58 | 7, | U5 | 7, | U34 | 35, | U36 | 7, | U35 | 7
Done |  | A6 | 6 | 0 | U33 | 8, | R58 | 8, | U5 | 8, | U34 | 36, | U36 | 6, | U35 | 6
Done |  | A7 | 6 | 0 | U33 | 9, | R58 | 9, | U5 | 9, | U34 | 37, | U36 | 5, | U35 | 5
Done |  | A12 | 5 | 0 | R59 | 6, | U2 | 6, | U34 | 2, | U36 | 4, | U35 | 4
Done |  | MA15 | 5 | 0 | U4 | 3, | R8 | 3, | U24 | 9, | U36 | 3, | U35 | 3
Done | N/C | unnamed_net83 | 1 | 0 | U7 | 12
Done | N/C | unnamed_net82 | 1 | 0 | U38 | 11
Done | N/C | unnamed_net81 | 1 | 0 | U32 | 11
Done |  | unnamed_net80 | 2 | 0 | D6 | 2, | D5 | 1
Done |  | -12V | 2 | 0 | J1 | B1, | J6 | B3
Done | N/C | unnamed_net79 | 1 | 0 | J6 | B2
Done | N/C | unnamed_net78 | 1 | 0 | J5 | B4
Done | N/C | unnamed_net77 | 1 | 0 | U11 | 5
Done |  | \_MREQ_NV\_ | 3 | 0 | U15 | 9, | U15 | 5, | U11 | 12
Done | N/C | unnamed_net76 | 1 | 0 | U11 | 14
Done | N/C | unnamed_net75 | 1 | 0 | U11 | 6
Done | N/C | unnamed_net74 | 1 | 0 | U11 | 10
Done | N/C | unnamed_net73 | 1 | 0 | U11 | 8
Done | N/C | unnamed_net72 | 1 | 0 | U11 | 7
Done | N/C | unnamed_net71 | 1 | 0 | U11 | 11
Done |  | RAM_VCC | 6 | 0 | C7 | 2, | U36 | 32, | C6 | 2, | U35 | 32, | U11 | 2, | C4 | 2
Done |  | unnamed_net70 | 3 | 0 | U11 | 1, | U44 | 3, | C3 | 1
Done |  | unnamed_net69 | 2 | 0 | B2 | 1, | B1 | 2
Done |  | unnamed_net68 | 2 | 0 | R2 | 1, | B1 | 1
Done |  | unnamed_net67 | 2 | 0 | R2 | 2, | D3 | 1
Done |  | unnamed_net66 | 5 | 0 | U44 | 2, | C1 | 2, | C2 | 1, | D3 | 2, | D2 | 2
Done |  | unnamed_net65 | 3 | 0 | D1 | 1, | D2 | 1, | R1 | 1
Done |  | +12V | 3 | 0 | J1 | A1, | J6 | B4, | R1 | 2
Done |  | \_INT\_ | 4 | 0 | R33 | 4, | U6 | 7, | U34 | 16, | U40 | 8
Done |  | IO_BUF_DIR | 3 | 0 | J1 | A20, | U23 | 1, | U32 | 8
Done |  | \_LV_IO_BUF_EN\_ | 2 | 0 | J1 | A21, | U32 | 6
Done |  | \_IO_BUF_EN\_ | 2 | 0 | U23 | 19, | U30 | 3
Done |  | \_MMAP_EN\_ | 4 | 0 | J1 | B8, | U25 | 11, | U24 | 11, | R5 | 8
Done |  | \_MMAP_IO_SEL\_ | 4 | 0 | J1 | A7, | U25 | 12, | U24 | 12, | R5 | 7
Done |  | POW_RST | 2 | 0 | U11 | 16, | R5 | 6
Done |  | \_LV_PNL_DAT_RD\_ | 3 | 0 | U30 | 4, | R5 | 4 | J1 | B7
Done |  | \_LV_INT\_ | 3 | 0 | U40 | 9, | R5 | 2 | J1 | A6
Done |  | +3.3V | 9 | 0 | J1 | A27, | J1 | A32, | J1 | A22, | J1 | A12, | U33 | 1, | U13 | 1, | D4 | 2, | J5 | B2, | R5 | 1
Done |  | \_NMI\_ | 4 | 0 | R33 | 3, | U6 | 8, | U34 | 17, | U42 | 11
Done |  | \_LV_NMI\_ | 3 | 0 | R5 | 3, | U42 | 13 | J1 | B6
Done |  | unnamed_net64 | 2 | 0 | U32 | 4, | U20 | 8
Done |  | unnamed_net63 | 2 | 0 | U30 | 2, | U20 | 9
Done |  | \_WR\_ | 6 | 0 | U13 | 7, | R61 | 4, | U1 | 7, | U34 | 22, | U32 | 9, | U20 | 2
Done | N/C | unnamed_net62 | 1 | 0 | U20 | 6
Done |  | unnamed_net61 | 2 | 0 | U32 | 10, | U20 | 5
Done |  | \_MREQ\_ | 6 | 0 | U13 | 4, | R61 | 7, | U1 | 4, | U34 | 19, | U11 | 13, | U21 | 5
Done |  | \_IORQ\_ | 6 | 0 | U13 | 5, | R61 | 6, | U1 | 5, | U34 | 20, | U20 | 12, | U21 | 4
Done |  | LV_IOWAIT | 3 | 0 | J1 | A8, | R5 | 5, | U42 | 5
Done |  | \_M1\_ | 5 | 0 | U13 | 3, | R61 | 8, | U1 | 3, | U34 | 27, | U31 | 3
Done |  | RFSH | 9 | 0 | U2 | 19, | U3 | 19, | U3 | 1, | U2 | 1, | U5 | 19, | U5 | 1, | U4 | 19, | U4 | 1, | U31 | 2
Done |  | \_RFSH\_ | 3 | 0 | U32 | 1, | U34 | 28, | U31 | 1
Done |  | PRE_WAIT | 3 | 0 | U42 | 6, | U42 | 9, | U41 | 2
Done |  | \_WAIT\_ | 4 | 0 | R33 | 5, | U6 | 6, | U34 | 24, | U41 | 6
Done | N/C | unnamed_net60 | 1 | 0 | U41 | 5
Done |  | \_FPGA_BUF_INH\_ | 2 | 0 | U32 | 5, | U31 | 12
Done |  | DO_WRITEORNEXT | 2 | 0 | U18 | 6, | U18 | 2
Done |  | unnamed_net59 | 4 | 0 | U19 | 9, | U19 | 10, | U19 | 13, | U30 | 11
Done |  | unnamed_net58 | 2 | 0 | U40 | 11, | U39 | 2
Done |  | \_RAM_WE\_ | 3 | 0 | U36 | 29, | U35 | 29, | U40 | 6
Done |  | DO_STEPORNEXT | 4 | 0 | U18 | 12, | U18 | 8, | U19 | 12, | U40 | 5
Done |  | unnamed_net57 | 2 | 0 | U19 | 8, | U40 | 4
Done |  | \_PNL_LATCH_OE_RQ\_ | 2 | 0 | U30 | 5, | U40 | 3
Done |  | \_RAM_OE\_ | 3 | 0 | U36 | 24, | U35 | 24, | U42 | 3
Done |  | \_RD\_ | 6 | 0 | U13 | 6, | R61 | 5, | U1 | 6, | U34 | 21, | U31 | 11, | U42 | 2
Done |  | unnamed_net56 | 3 | 0 | U31 | 13, | U39 | 8, | U42 | 1
Done |  | unnamed_net55 | 2 | 0 | U39 | 11, | U19 | 5
Done |  | \_PNL_IO_BUF_EN\_ | 3 | 0 | U30 | 1, | U40 | 1, | U19 | 6
Done |  | unnamed_net54 | 2 | 0 | U18 | 3, | U39 | 5
Done |  | USE_PNL_DATA | 3 | 0 | U19 | 4, | U39 | 9, | U39 | 6
Done |  | \_DO_D\_ | 3 | 0 | U39 | 13, | U30 | 13, | U29 | 14
Done | N/C | unnamed_net53 | 1 | 0 | U29 | 11
Done | N/C | unnamed_net52 | 1 | 0 | U29 | 6
Done | N/C | unnamed_net51 | 1 | 0 | U29 | 3
Done |  | unnamed_net50 | 2 | 0 | U39 | 3, | U29 | 13
Done |  | DO_C | 3 | 0 | U30 | 12, | U39 | 1, | U29 | 10
Done |  | DO_B | 3 | 0 | U39 | 12, | U29 | 12, | U29 | 7
Done |  | DO_A | 3 | 0 | U39 | 10, | U29 | 5, | U29 | 2
Done |  | unnamed_net49 | 2 | 0 | U18 | 11, | U29 | 4
Done |  | RD | 3 | 0 | U31 | 10, | U39 | 4, | U21 | 10
Done |  | M1 | 2 | 0 | U31 | 4, | U21 | 13
Done |  | PNL_WAIT | 2 | 0 | U42 | 4, | U28 | 13
Done |  | DO_WRITE | 4 | 0 | U40 | 12, | U18 | 13, | U18 | 4, | U28 | 9
Done |  | CYCLE | 3 | 0 | U20 | 10, | U31 | 6, | U28 | 15
Done |  | \_DO_CYCLE\_ | 2 | 0 | U19 | 11, | U28 | 14
Done |  | DO_STEP | 2 | 0 | U18 | 10, | U28 | 7
Done |  | DO_NEXT | 4 | 0 | U18 | 9, | U18 | 5, | U40 | 2, | U28 | 4
Done |  | \_PNL_OP_DONE\_ | 4 | 0 | U30 | 8, | U28 | 5, | U28 | 10, | U28 | 1
Done |  | \_DO_E\_ | 2 | 0 | U30 | 9, | U27 | 14
Done | N/C | unnamed_net48 | 1 | 0 | U27 | 15
Done |  | DO_D | 2 | 0 | U29 | 15, | U27 | 13
Done | N/C | unnamed_net47 | 1 | 0 | U27 | 10
Done | N/C | unnamed_net46 | 1 | 0 | U27 | 7
Done | N/C | unnamed_net45 | 1 | 0 | U27 | 2
Done |  | unnamed_net44 | 3 | 0 | U21 | 8, | U27 | 12, | U38 | 9
Done |  | unnamed_net43 | 2 | 0 | U27 | 11, | U38 | 10
Done |  | unnamed_net42 | 3 | 0 | U28 | 12, | U28 | 11, | U38 | 8
Done |  | unnamed_net41 | 2 | 0 | U27 | 6, | U38 | 5
Done |  | unnamed_net40 | 2 | 0 | U28 | 6, | U38 | 6
Done |  | unnamed_net39 | 3 | 0 | U21 | 11, | U27 | 4, | U38 | 1
Done |  | unnamed_net38 | 2 | 0 | U27 | 3, | U38 | 2
Done |  | unnamed_net37 | 3 | 0 | U28 | 3, | U28 | 2, | U38 | 3
Done |  | \_CYCLE\_ | 5 | 0 | U21 | 6, | U42 | 10, | U31 | 5, | U40 | 13, | U41 | 11
Done | N/C | unnamed_net36 | 1 | 0 | U41 | 9
Done |  | unnamed_net35 | 2 | 0 | U41 | 10, | U19 | 3
Done |  | \_RUN\_ | 4 | 0 | U40 | 10, | U42 | 12, | U41 | 8, | U21 | 1
Done |  | NEXT | 2 | 0 | U21 | 12, | U26 | 9
Done |  | unnamed_net34 | 2 | 0 | U26 | 6, | U26 | 8
Done |  | unnamed_net33 | 2 | 0 | U7 | 6, | U26 | 7
Done |  | STEP | 3 | 0 | U27 | 5, | U38 | 4, | U26 | 5
Done |  | MAN | 2 | 0 | U18 | 1, | U26 | 19
Done |  | unnamed_net32 | 2 | 0 | U26 | 18, | U26 | 16
Done |  | unnamed_net31 | 2 | 0 | U7 | 8, | U26 | 17
Done |  | WRITE | 2 | 0 | U21 | 9, | U26 | 15
Done |  | unnamed_net30 | 2 | 0 | U26 | 14, | U26 | 12
Done |  | unnamed_net29 | 2 | 0 | U7 | 10, | U26 | 13
Done |  | unnamed_net28 | 2 | 0 | U21 | 3, | U26 | 1
Done |  | unnamed_net27 | 2 | 0 | U26 | 2, | U26 | 4
Done |  | unnamed_net26 | 2 | 0 | U7 | 4, | U26 | 3
Done |  | NMI_SWITCH | 2 | 0 | J1 | A9, | U16 | 9
Done |  | unnamed_net25 | 2 | 0 | U16 | 6, | U16 | 8
Done |  | unnamed_net24 | 2 | 0 | U7 | 2, | U16 | 7
Done |  | \_RESET\_ | 8 | 0 | J1 | B9, | R33 | 2, | U6 | 9, | U34 | 26, | U30 | 10, | U29 | 1, | U27 | 1, | U16 | 5
Done | N/C | unnamed_net23 | 1 | 0 | U16 | 19
Done |  | \_STOP_2\_ | 3 | 0 | U41 | 13, | U19 | 2, | U16 | 16
Done |  | \_STOP_1\_ | 4 | 0 | U41 | 12, | U16 | 17, | U19 | 1, | U16 | 15
Done |  | unnamed_net22 | 2 | 0 | U16 | 14, | U16 | 12
Done |  | \_POW_RST\_ | 3 | 0 | U11 | 15, | U21 | 2, | U16 | 1
Done |  | unnamed_net21 | 2 | 0 | U16 | 2, | U16 | 4
Done |  | PNL_LATCH_EN | 2 | 0 | U42 | 8, | U43 | 11
Done |  | BD7 | 5 | 0 | J1 | B26, | R62 | 2, | U23 | 11, | U25 | 3, | U43 | 19
Done |  | BD6 | 5 | 0 | J1 | A26, | R62 | 3, | U23 | 12, | U25 | 2, | U43 | 16
Done |  | BD5 | 5 | 0 | J1 | B25, | R62 | 4, | U23 | 13, | U25 | 1, | U43 | 15
Done |  | BD4 | 5 | 0 | J1 | A25, | R62 | 5, | U23 | 14, | U25 | 15, | U43 | 12
Done |  | BD3 | 5 | 0 | J1 | B24, | R62 | 6, | U23 | 15, | U24 | 3, | U43 | 9
Done |  | BD2 | 5 | 0 | J1 | A24, | R62 | 7, | U23 | 16, | U24 | 2, | U43 | 6
Done |  | BD1 | 5 | 0 | J1 | B23, | R62 | 8, | U23 | 17, | U24 | 1, | U43 | 5
Done |  | BD0 | 5 | 0 | J1 | A23, | R62 | 9, | U23 | 18, | U24 | 15, | U43 | 2
Done |  | \_PNL_LATCH_OE\_ | 2 | 0 | U30 | 6, | U43 | 1
Done |  | \_SW_RESET_NO\_ | 3 | 0 | R4 | 8, | U16 | 3, | J4 | 24
Done | N/C | \_SW_RESET_NC\_ | 1 | 0 | J4 | 23
Done |  | \_SW_NMI_NO\_ | 3 | 0 | U7 | 1, | R4 | 7, | J4 | 22
Done | N/C | \_SW_NMI_NC\_ | 1 | 0 | J4 | 21
Done |  | LED_PWR | 7 | 0 | J2 | 2, | J2 | 1, | J3 | 26, | J3 | 25, | R63 | 2, | D6 | 1, | J4 | 20
Done |  | \_SW_STOP\_ | 3 | 0 | R4 | 6, | U16 | 13, | J4 | 18
Done |  | \_SW_STEP_NO\_ | 3 | 0 | U7 | 3, | R4 | 5, | J4 | 17
Done | N/C | \_SW_STEP_NC\_ | 1 | 0 | J4 | 16
Done |  | \_SW_NEXT_NO\_ | 3 | 0 | U7 | 5, | R4 | 4, | J4 | 15
Done | N/C | \_SW_NEXT_NC\_ | 1 | 0 | J4 | 14
Done |  | \_SW_WRITE_NO\_ | 3 | 0 | U7 | 11, | R4 | 3, | J4 | 13
Done | N/C | \_SW_WRITE_NC\_ | 1 | 0 | J4 | 12
Done |  | \_SW_MAN\_ | 3 | 0 | U7 | 9, | R4 | 2, | J4 | 11
Done |  | Vcc | 32 | 0 | J1 | B10, | J1 | A10, | R61 | 1, | U1 | 20, | R33 | 1, | U6 | 20, | R8 | 1, | U34 | 11, | U34 | 25, | D5 | 2, | D4 | 1, | C8 | 1, | J5 | B3, | U11 | 3, | C5 | 2, | D1 | 2, | U20 | 13, | U20 | 14, | U20 | 4, | U20 | 1, | U41 | 4, | U41 | 1, | U29 | 16, | U27 | 16, | U41 | 14, | R4 | 1, | U26 | 20, | U16
Done |  | SW_PD0 | 3 | 0 | U43 | 3, | R3 | 2, | J4 | 8
Done |  | SW_PD1 | 3 | 0 | U43 | 4, | R3 | 3, | J4 | 7
Done |  | SW_PD2 | 3 | 0 | U43 | 7, | R3 | 4, | J4 | 6
Done |  | SW_PD3 | 3 | 0 | U43 | 8, | R3 | 5, | J4 | 5
Done |  | SW_PD4 | 3 | 0 | U43 | 13, | R3 | 6, | J4 | 4
Done |  | SW_PD5 | 3 | 0 | U43 | 14, | R3 | 7, | J4 | 3
Done |  | SW_PD6 | 3 | 0 | U43 | 17, | R3 | 8, | J4 | 2
Done |  | SW_PD7 | 3 | 0 | U43 | 18, | R3 | 9, | J4 | 1
Done |  | CPU_CLK_B | 7 | 0 | U13 | 2, | U20 | 11, | U20 | 3, | U41 | 3, | U29 | 9, | U27 | 9, | U31 | 8
Done |  | CPU_CLK | 2 | 0 | U34 | 6, | U14 | 12
Done | N/C | unnamed_net20 | 1 | 0 | U9 | 9
Done | N/C | unnamed_net19 | 1 | 0 | U9 | 10
Done | N/C | unnamed_net18 | 1 | 0 | U9 | 11
Done | N/C | unnamed_net17 | 1 | 0 | U10 | 1
Done |  | PNL_CLK | 3 | 0 | U26 | 11, | U16 | 11, | U10 | 15
Done | N/C | unnamed_net16 | 1 | 0 | U10 | 14
Done | N/C | unnamed_net15 | 1 | 0 | U10 | 12
Done | N/C | unnamed_net14 | 1 | 0 | U10 | 13
Done | N/C | unnamed_net13 | 1 | 0 | U10 | 4
Done | N/C | unnamed_net12 | 1 | 0 | U10 | 2
Done | N/C | unnamed_net11 | 1 | 0 | U10 | 3
Done | N/C | unnamed_net10 | 1 | 0 | U10 | 5
Done | N/C | unnamed_net9 | 1 | 0 | U10 | 6
Done | N/C | unnamed_net8 | 1 | 0 | U10 | 7
Done | N/C | unnamed_net7 | 1 | 0 | U10 | 9
Done |  | unnamed_net6 | 2 | 0 | U9 | 8, | U10 | 10
Done |  | VCC | 26 | 0 | U33 | 20, | U13 | 20, | U23 | 20, | U3 | 20, | U2 | 20, | U5 | 20, | U4 | 20, | U15 | 14, | U25 | 16, | U24 | 16, | U32 | 14, | U18 | 14, | U30 | 14, | U40 | 14, | U42 | 14, | U39 | 14, | U28 | 16, | U38 | 14, | U7 | 14, | U19 | 14, | U21 | 14, | U31 | 14, | U8 | 14, | U14 | 14, | U10 | 16, | U9 | 14
Done |  | unnamed_net5 | 2 | 0 | U9 | 13, | U9 | 6
Done | N/C | unnamed_net4 | 1 | 0 | U9 | 5
Done |  | GND | 91 | 0 | J1 | B11, | J1 | B21, | J1 | B20, | J1 | B19, | J1 | B18, | J1 | B17, | J1 | B16, | J1 | B15, | J1 | B14, | J1 | B13, | J1 | B27, | J1 | B32, | J1 | B22, | J1 | B12, | U33 | 10, | U33 | 19, | U13 | 10, | U13 | 19, | R62 | 1, | U23 | 10, | R60 | 1, | R59 | 1, | R58 | 1, | U3 | 10, | U2 | 10, | U1 | 10, | U1 | 19, | U1
Done | N/C | unnamed_net3 | 1 | 0 | U9 | 4
Done |  | unnamed_net2 | 2 | 0 | U8 | 8, | U9 | 1
Done |  | unnamed_net1 | 3 | 0 | U31 | 9, | U14 | 13, | U9 | 3
 |  | END | nets
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
