rundel-tech/ZARC/(list of files, cad)

Other CAD files:
fpga/Firmware/output_files/stp1_auto_stripped.stp
fpga/Firmware/output_files/stp1.stp
fpga/Firmware/output_files/AllPins.stp
fpga/Firmware/output_files/SPI_Debug_auto_stripped.stp
fpga/Firmware/output_files/Trace_auto_stripped.stp
fpga/Firmware/output_files/AllPins_auto_stripped.stp
fpga/Firmware/output_files/I2C_Debug_auto_stripped.stp
fpga/Firmware/output_files/Interrupts_auto_stripped.stp
fpga/Firmware/output_files/I2C_Debug.stp
fpga/Firmware/output_files/Trace.stp
fpga/Firmware/output_files/Interrupts.stp
fpga/Firmware/output_files/SPI_Debug.stp
fpga/Firmware/simulation/modelsim/rtl_work/asyncser_rx/logic.psm
fpga/Firmware/simulation/modelsim/rtl_work/asyncser_tx/logic.psm
fpga/Firmware/simulation/modelsim/rtl_work/crc16_xmodem/logic.psm
fpga/Firmware/simulation/modelsim/rtl_work/definitions/_vhdl.psm
fpga/Firmware/simulation/modelsim/rtl_work/denoise/logic.psm
fpga/Firmware/simulation/modelsim/rtl_work/fifo_ram/syn.psm
fpga/Firmware/simulation/modelsim/rtl_work/fifos/logic.psm
fpga/Firmware/simulation/modelsim/rtl_work/i2c_master/logic.psm
fpga/Firmware/simulation/modelsim/rtl_work/intcontrol/logic.psm
fpga/Firmware/simulation/modelsim/rtl_work/main/logic.psm
fpga/Firmware/simulation/modelsim/rtl_work/mainpll/syn.psm
fpga/Firmware/simulation/modelsim/rtl_work/nmi_control/logic.psm
fpga/Firmware/simulation/modelsim/rtl_work/outexpander/logic.psm
fpga/Firmware/simulation/modelsim/rtl_work/spi_master/logic.psm
fpga/Firmware/simulation/modelsim/rtl_work/sync2ff/logic.psm
fpga/Firmware/simulation/modelsim/rtl_work/timing/logic.psm
fpga/Firmware/simulation/modelsim/rtl_work/trace_pre_tb/beh.psm
