rundel-tech/ZARC/software/cpm/cpm_dev/fsck/fsckGuide.odt

| fsck Users’ Guide

Written by Merlin Skinner-Oakes, 1/11/2022

Last updated: 19/2/2023

# Revision History

1 – initial release (fsck V1.0)

2 – updated to include “/s” option (fsck V1.1).

3 – added section #4.

4 – updated for fsck V1.3 (mainly CP/M 3 support).

5 – updated for fsck V1.4 (make command line case insensitive to ease use with replacement CCPs).

# Description

“FSCK” is an abbreviation for File System Consistency checK), as commonly found on Unix and Linux systems. This programme scans a CP/M 2.2 or CP/M 3 file system, and reports any error it finds. It does not attempt any kind of repairs. FSCK.COM is intended to run under CP/M 2.2 or CP/M 3 . It should run under any such system equipped with a Z80 processor.

In this document, the following style conventions are used:

Machine output

User commands

Comments

# Usage

The command format is:

fsck <drive>[:] [/options]

The colon after the drive letter is optional. Options available are:

- S - enables a surface scan to be performed after the file system check.
- 2 – use CP/M 2.x rules (default on CP/M 2.x systems). Passwords and disk labels are treated as errors, for example.
- 3 – use CP/M 3.x rules (default on CP/M 3.x systems).
- Q – quiet. Suppress all output other than warning and error messages.
- V – verbose. Provide additional information such as decoded passwords.
- B - show build information and exit

Disk format rules default to the system currently in use. For example, if fsck is run on a CP/M 3.x system, CP/M 3.x rules are used unless overridden by use of the “/2” option.

Options may also be entered as “$<options>” or “[<options>]”. The entire command line is not case sensitive. The following commands are all equivalent:

fsck b /s

fsck b:/s

fsck b: $S

FSCK b: [s]

The command “fsck” with no parameters will result in a terse reminder of the command format.

fsck

**** CP/M File System Checker V1.4 ***

Operand error. Expected format: fsck <drive>[:] [/<options>]

options: S=surface scan, 2=CP/M 2.x format, 3=CP/M 3.x format, Q=quiet,

V=verbose, B=show build information and exit

Example With Surface Scan

A>fsck b: /s

*** CP/M File System Checker V1.4 ***

CP/M 3 features enabled

Directory checks complete

Errors and warnings: 0

Files found: 34 including 0 system files and 0 read only files

Password protected files: 0

Unused directory entries: 474

Blocks used: 105 of 512

Block map ('D': directory, 'F': file and '-': unused).

DDDDDDDDFFFFFFFFFFFFFFFFFFFFFFFFFFFFFFFFFFFFFFFFFFFFFFFFFFFFFFFFFFFFFFFFFFFFFFFF

FFFFFFFFFFFFFFFFFFFFFFFFF-------------------------------------------------------

Checking all blocks are readable (surface scan)

Track: 31

Scan complete

Example With Password Decoding

A>fsck f: /vq

U0 HELP .$$$ - no allocations in physical extent [warning]

U0 LS .$$$ - no allocations in physical extent [warning]

Label: LABEL .

U0 DUMP .COM requires password

"WIBBLE " to (delete) (write to) (read from) the file

# Checks Performed

Each directory entry is scanned in turn, and a list (internally called files_info) is constructed with one entry per file. This contains a bitmap of physical extents encountered, so it is possible to discover "holes" (also known as sparse files) as well as duplicated extents. Once the directory scan is complete, a block map is displayed. This shows how blocks are distributed on the disk. Finally, an optional surface scan is performed to ensure that all sectors are readable. This includes sectors not allocated to any file.

fsck checks each directory entry for the following errors:

- User number out of range (>15)
- Illegal characters in the file name or file type
- Extent count out of range (low byte >=32)
- S1 (“last record byte count”) is appropriate for the system in use.
- A file contains a duplicated physical extent
- Block number is out of range

Some other errors detected are:

- "Sparse" files, i.e. ones with gaps in their allocations (warning) *1
- Physical extents with no allocations at all (warning)
- Record count should be 0x80 for all but the last extent
- A block is allocated more than once
- Password peculiarities, such a a password with no associated file or multiple passwords for the same file
- Misplaced CP/M 3.x timestamp entries
- Multiple CP/M 3.x disk labels found
- Inconsistent file attributes. Different directory entries have conflicting settings attributes such as read-only, system (hidden) and archive.

Notes:

*1 Sparse files are not actually illegal in CP/M, but they are somewhat unusual and so worth warning about.

FSCK Users’ Guide Revision 5 Page 3 of 3
