rundel-tech/ZARC/hardware/CAD/IO/Output/Schematics.pdf

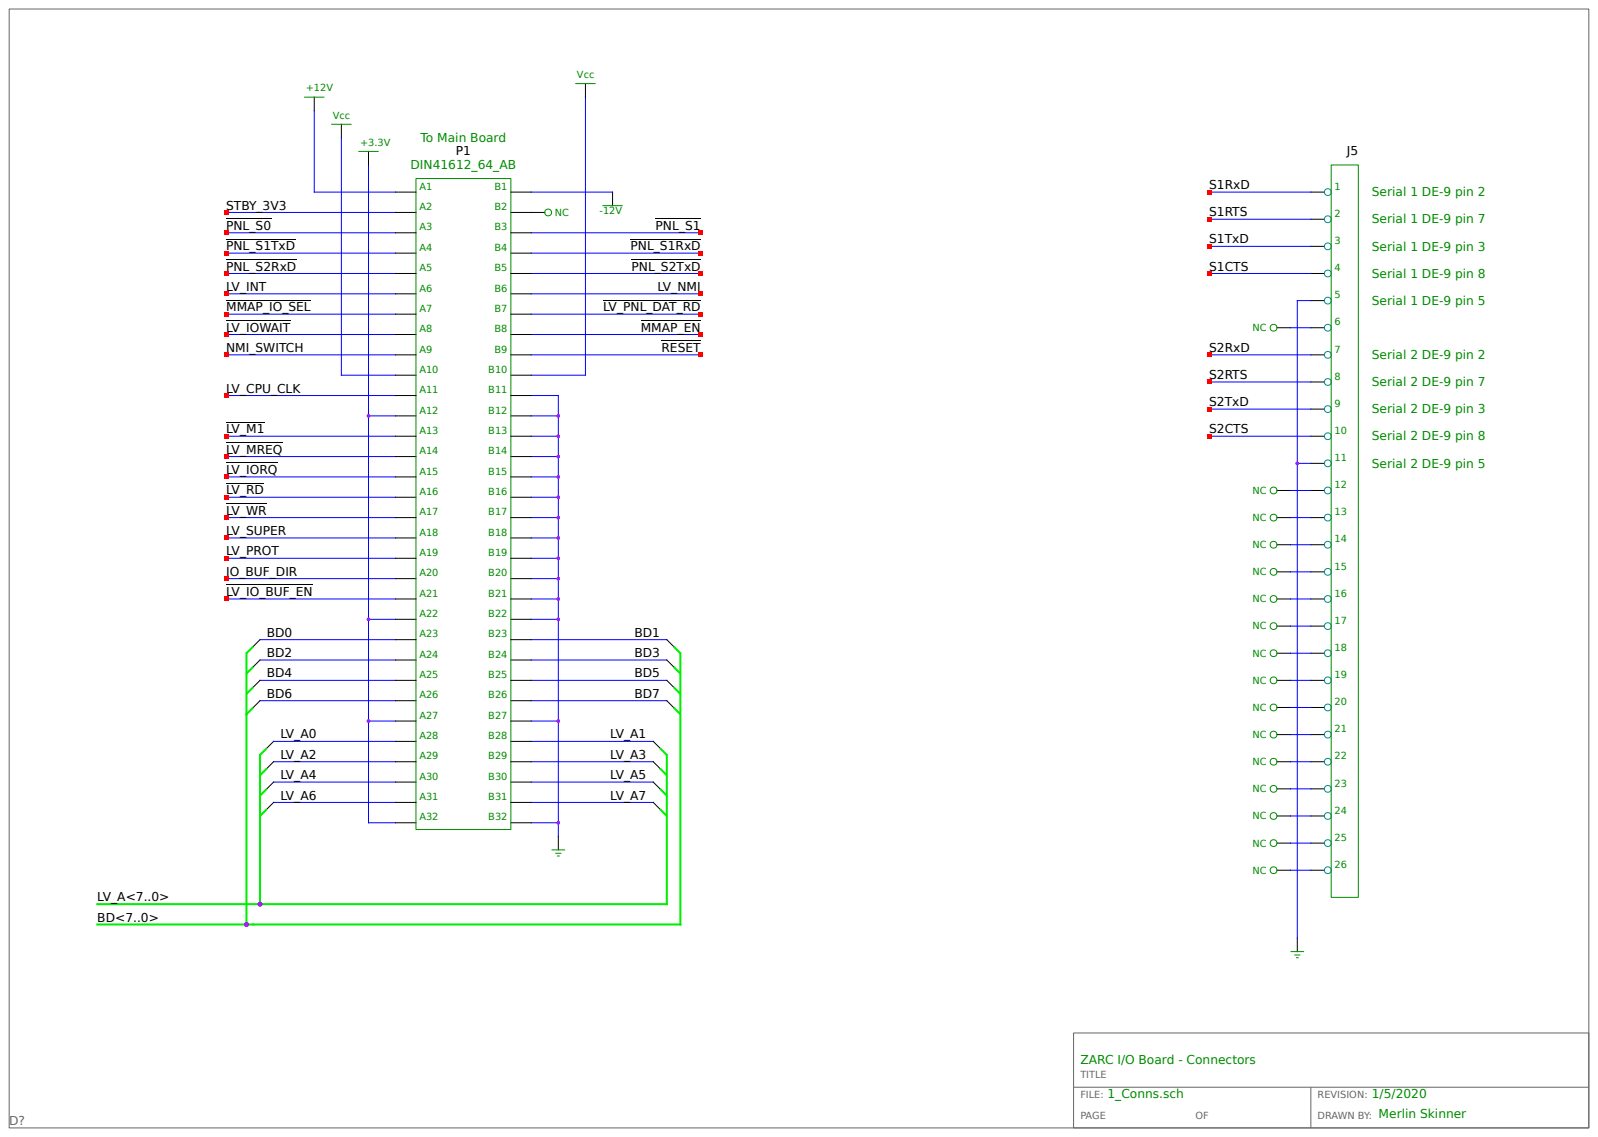
[picture p9: page 1]
FILE:; REVISION:; PAGE; DRAWN BY:; Merlin Skinner; LV_IO_BUF_EN; LV_CPU_CLK; LV_MREQ LV_IORQ LV_RD LV_WR LV_SUPER LV_PROT IO_BUF_DIR; Vcc; NMI_SWITCH; RESET; LV_IOWAIT; MMAP_IO_SEL; MMAP_EN; PNL_S1TxD PNL_S2RxD; LV_PNL_DAT_RD; LV_INT; LV_NMI; PNL_S1RxD PNL_S2TxD; PNL_S0; PNL_S1; STBY_3V3; DIN41612_64_AB; S1RxD; S1RTS; S1CTS; S2RxD; S2RTS; S2CTS; S2TxD; S1TxD

To Main Board

Serial 1 DE-9 pin 2

Serial 1 DE-9 pin 7

Serial 1 DE-9 pin 3

Serial 1 DE-9 pin 8

Serial 1 DE-9 pin 5

Serial 2 DE-9 pin 2

Serial 2 DE-9 pin 7

Serial 2 DE-9 pin 3

Serial 2 DE-9 pin 8

Serial 2 DE-9 pin 5

ZARC I/O Board - Connectors
TITLE
1_Conns.sch

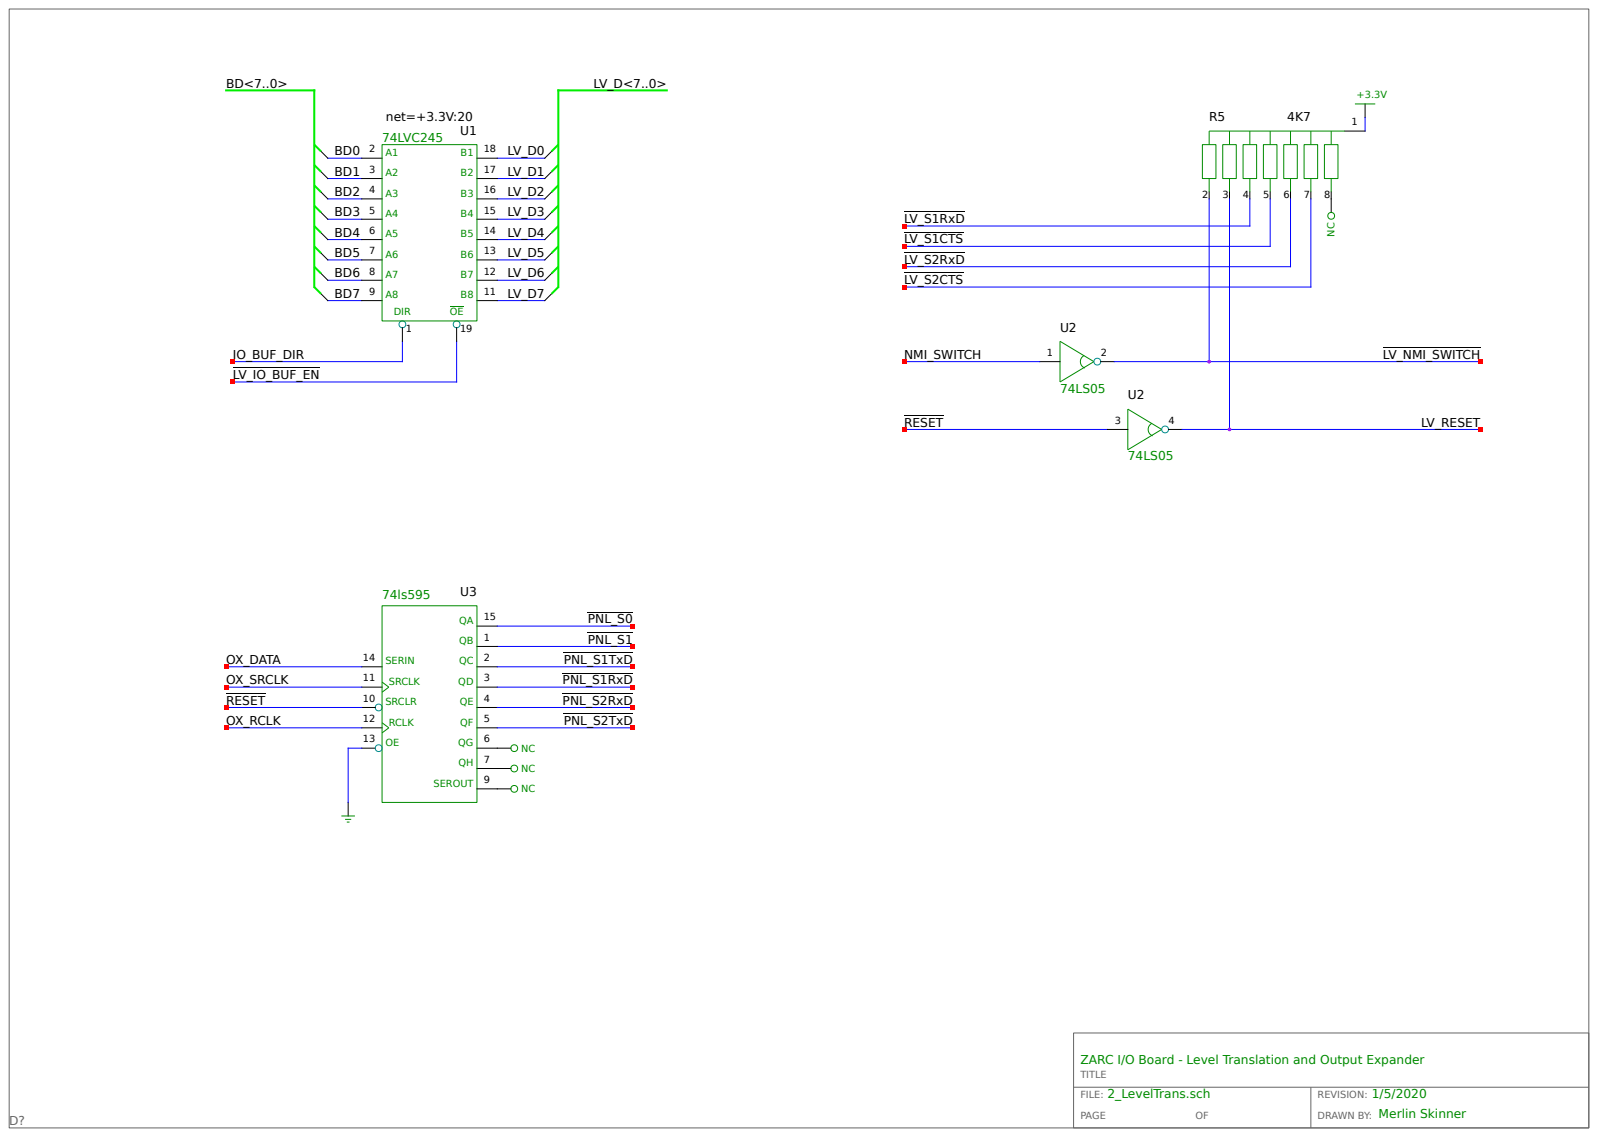
[picture p10: page 2]
2_LevelTrans.sch; IO_BUF_DIR LV_IO_BUF_EN; NMI_SWITCH; RESET; LV_NMI_SWITCH; LV_RESET; LV_S1RxD LV_S1CTS; PNL_S1; DIR; 74LVC245 U1; net=+3.3V:20; 12 RCLK; 11 SRCLK; 14 SERIN; QE 4 SRCLR; 9 SEROUT; OX_DATA OX_SRCLK RESET OX_RCLK; PNL_S0; PNL_S1TxD PNL_S1RxD PNL_S2RxD PNL_S2TxD; LV_S2RxD LV_S2CTS

ZARC I/O Board - Level Translation and Output Expander

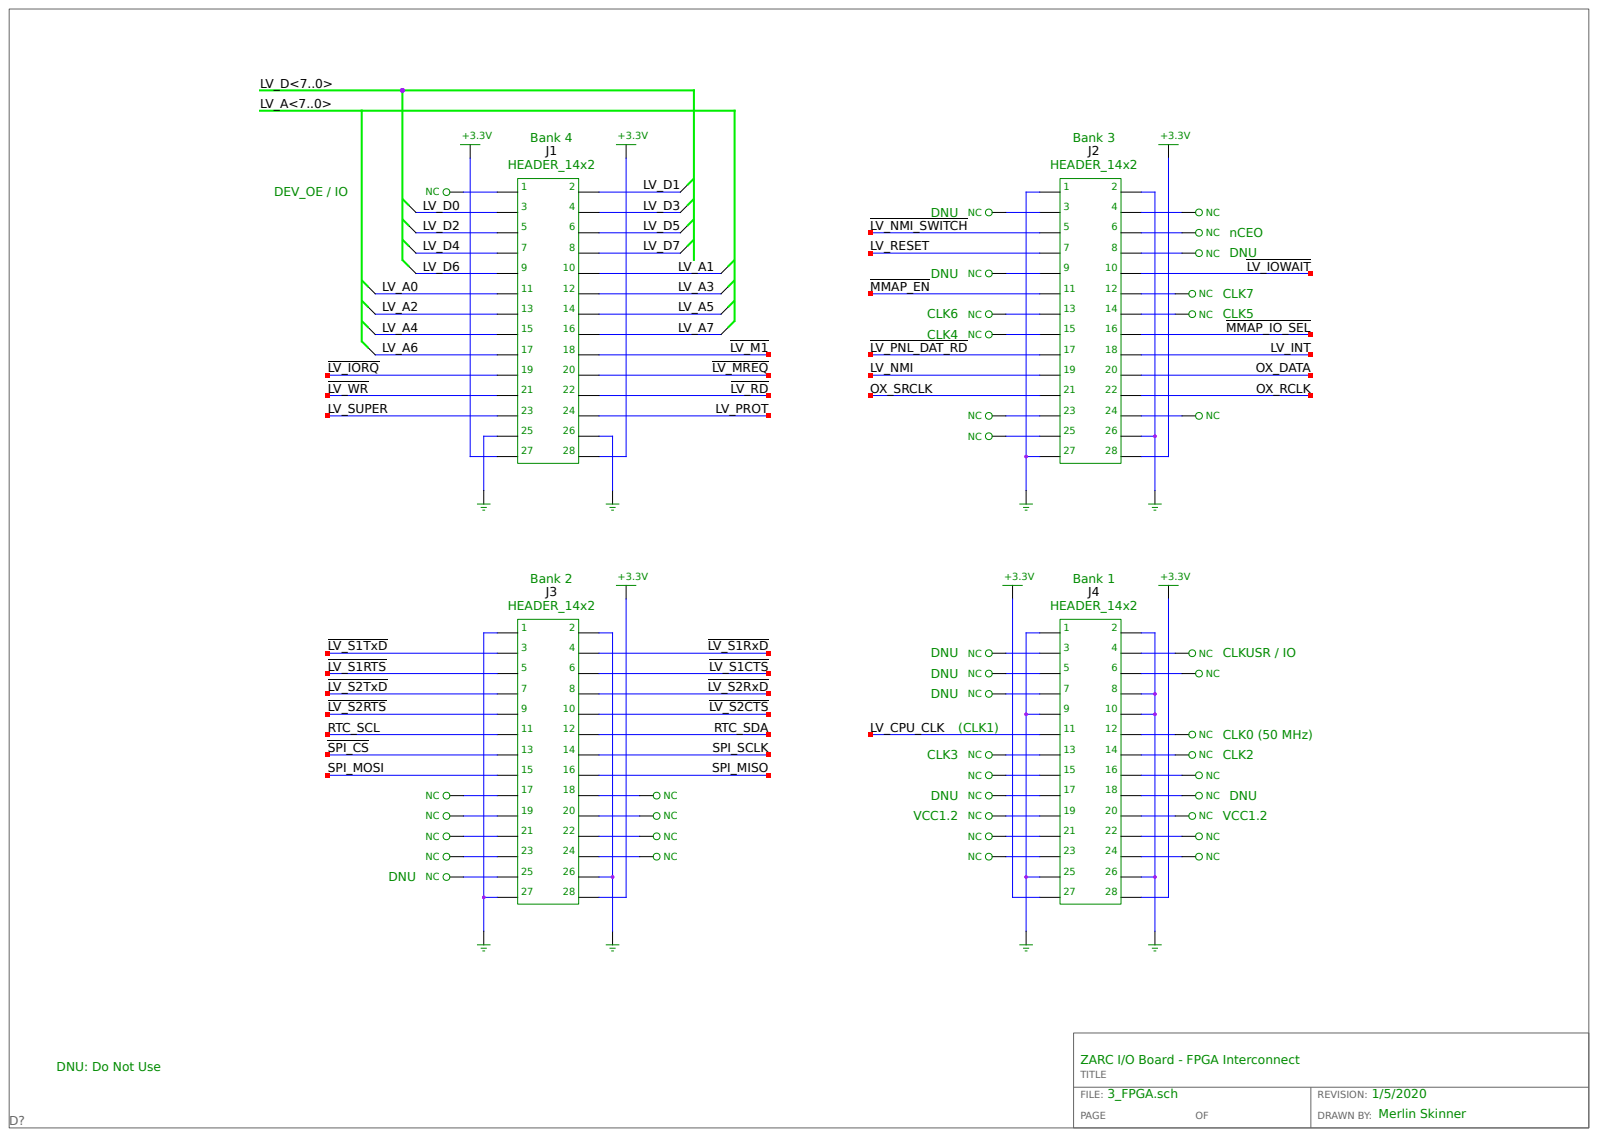
[picture p11: page 3]
3_FPGA.sch; HEADER_14x2; Bank 4; Bank 3; Bank 2; Bank 1; LV_IORQ; LV_MREQ; LV_NMI_SWITCH LV_RESET; CLK6 NC; CLK7 CLK5; DEV_OE / IO; NC CLKUSR / IO; LV_CPU_CLK; NC CLK0 (50 MHz) (CLK1); CLK3 NC; NC CLK2; VCC1.2 NC; NC VCC1.2; OX_SRCLK; LV_NMI; OX_DATA; LV_INT; LV_IOWAIT; NC nCEO; LV_PNL_DAT_RD; CLK4 NC; LV_SUPER; LV_PROT; MMAP_IO_SEL; MMAP_EN; DNU; DNU NC; DNU NC DNU NC; NC DNU; LV_S1TxD; LV_S1RxD; LV_S1RTS; LV_S1CTS; LV_S2TxD; LV_S2RxD; LV_S2RTS; LV_S2CTS; OX_RCLK; RTC_SCL; RTC_SDA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

ZARC I/O Board - FPGA Interconnect

DNU: Do Not Use

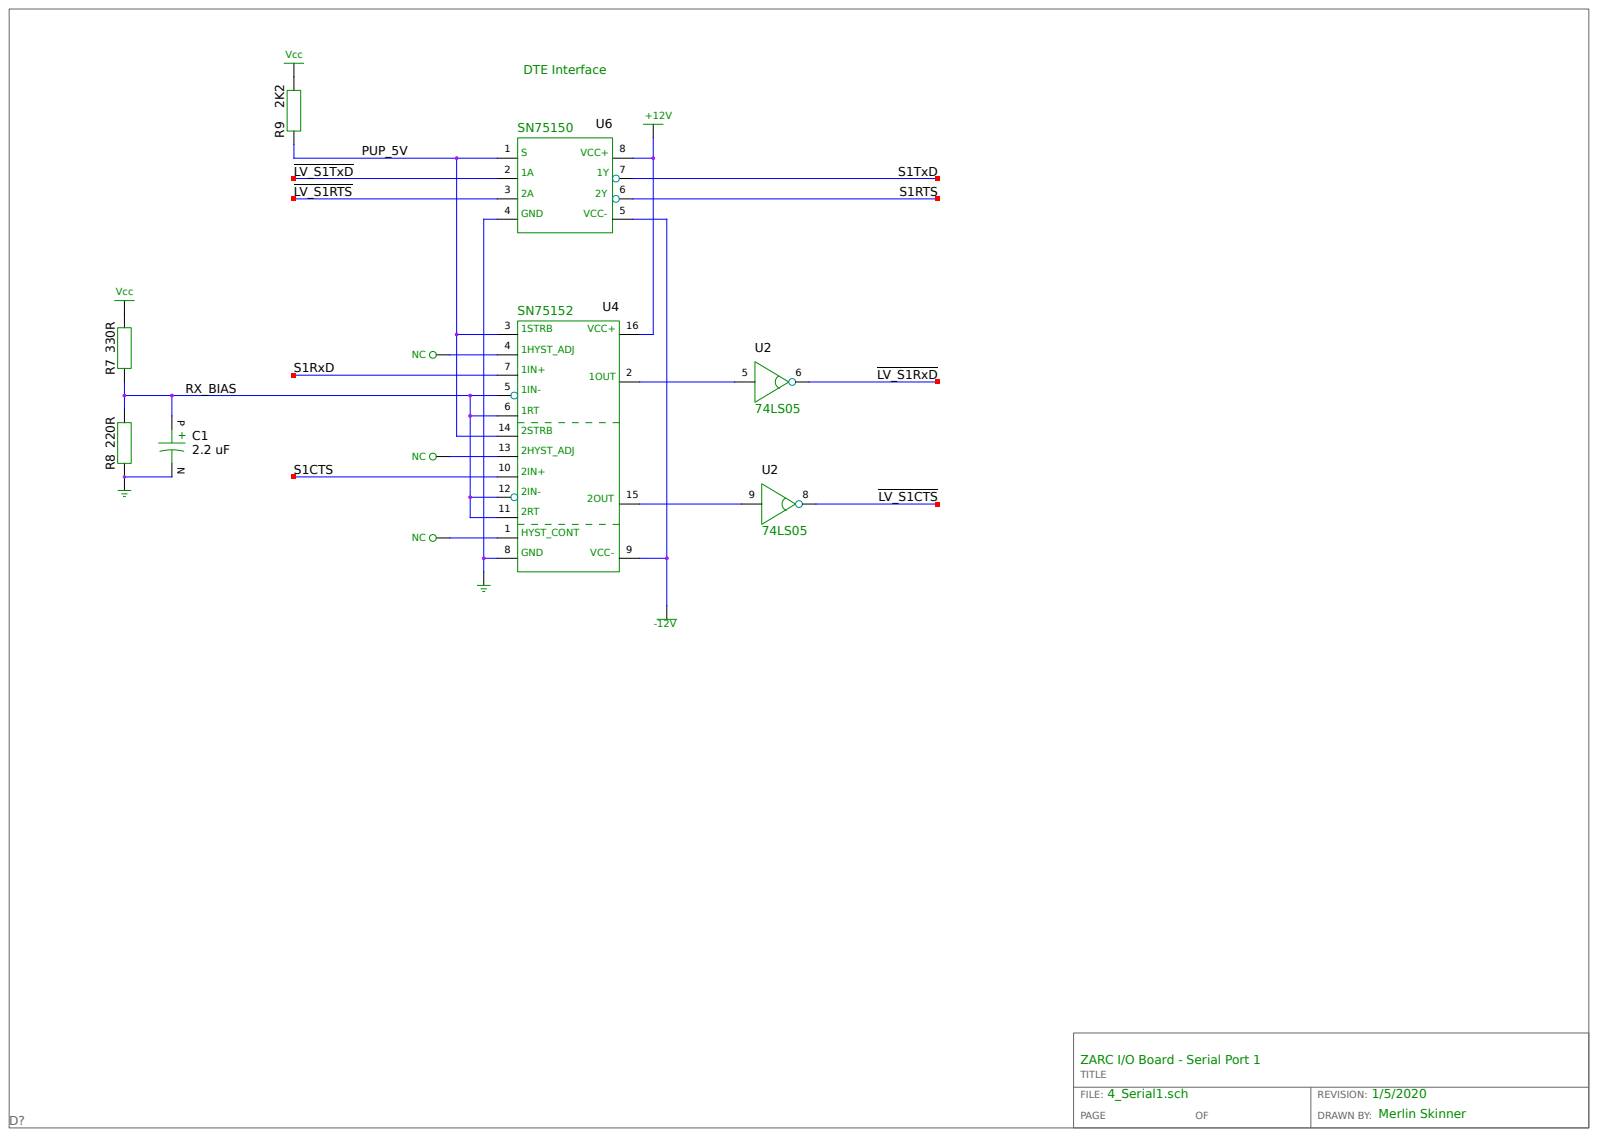
[picture p12: page 4]
4_Serial1.sch; 8 VCC+; 4 GND; 5 VCC-; 16 VCC+; 2 1OUT; 8 GND; 15 2OUT; 9 VCC-; 14 2STRB; 13 2HYST_ADJ; 3 1STRB; 4 1HYST_ADJ; 1 HYST_CONT; DTE Interface; S1TxD S1RTS; S1RxD; S1CTS; PUP_5V; LV_S1TxD LV_S1RTS; LV_S1RxD; LV_S1CTS; RX_BIAS; Vcc

ZARC I/O Board - Serial Port 1

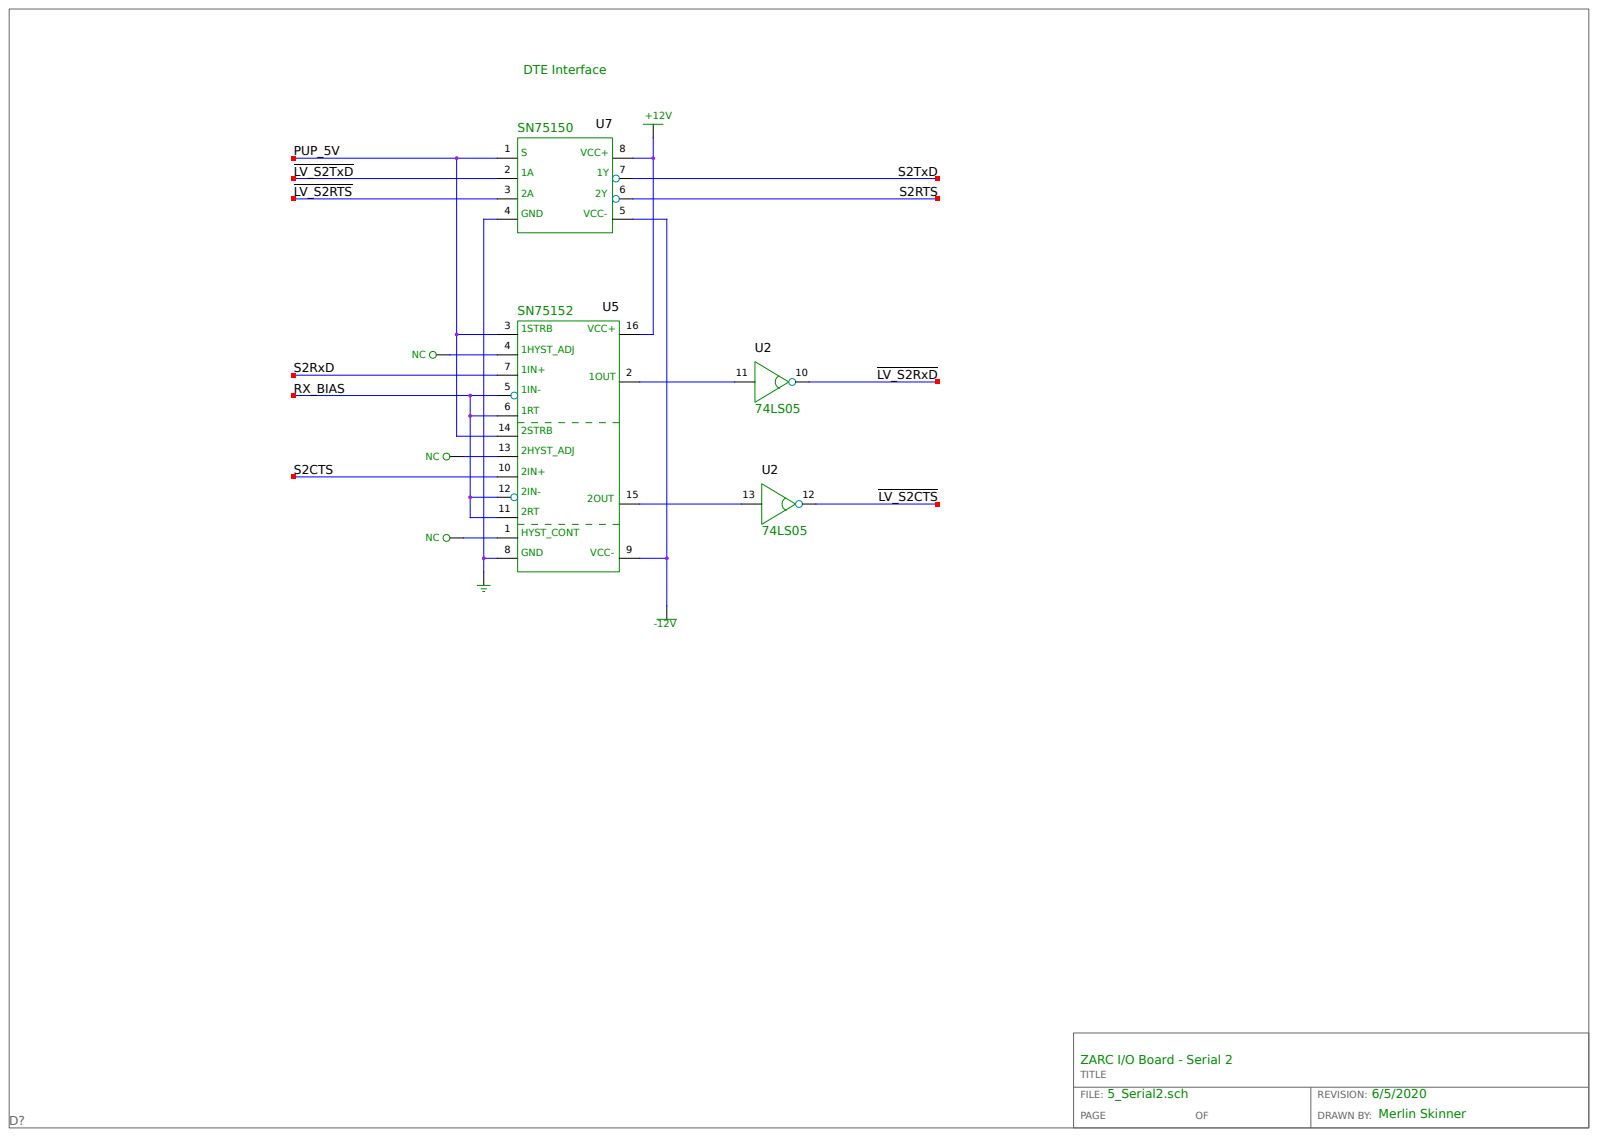
[picture p13: page 5]
5_Serial2.sch; 8 VCC+; 4 GND; 5 VCC-; 16 VCC+; 2 1OUT; 8 GND; 15 2OUT; 9 VCC-; 14 2STRB; 13 2HYST_ADJ; 3 1STRB; 4 1HYST_ADJ; 1 HYST_CONT; DTE Interface; S2TxD S2RTS; S2RxD; S2CTS; PUP_5V LV_S2TxD LV_S2RTS; LV_S2RxD; LV_S2CTS; RX_BIAS

ZARC I/O Board - Serial 2

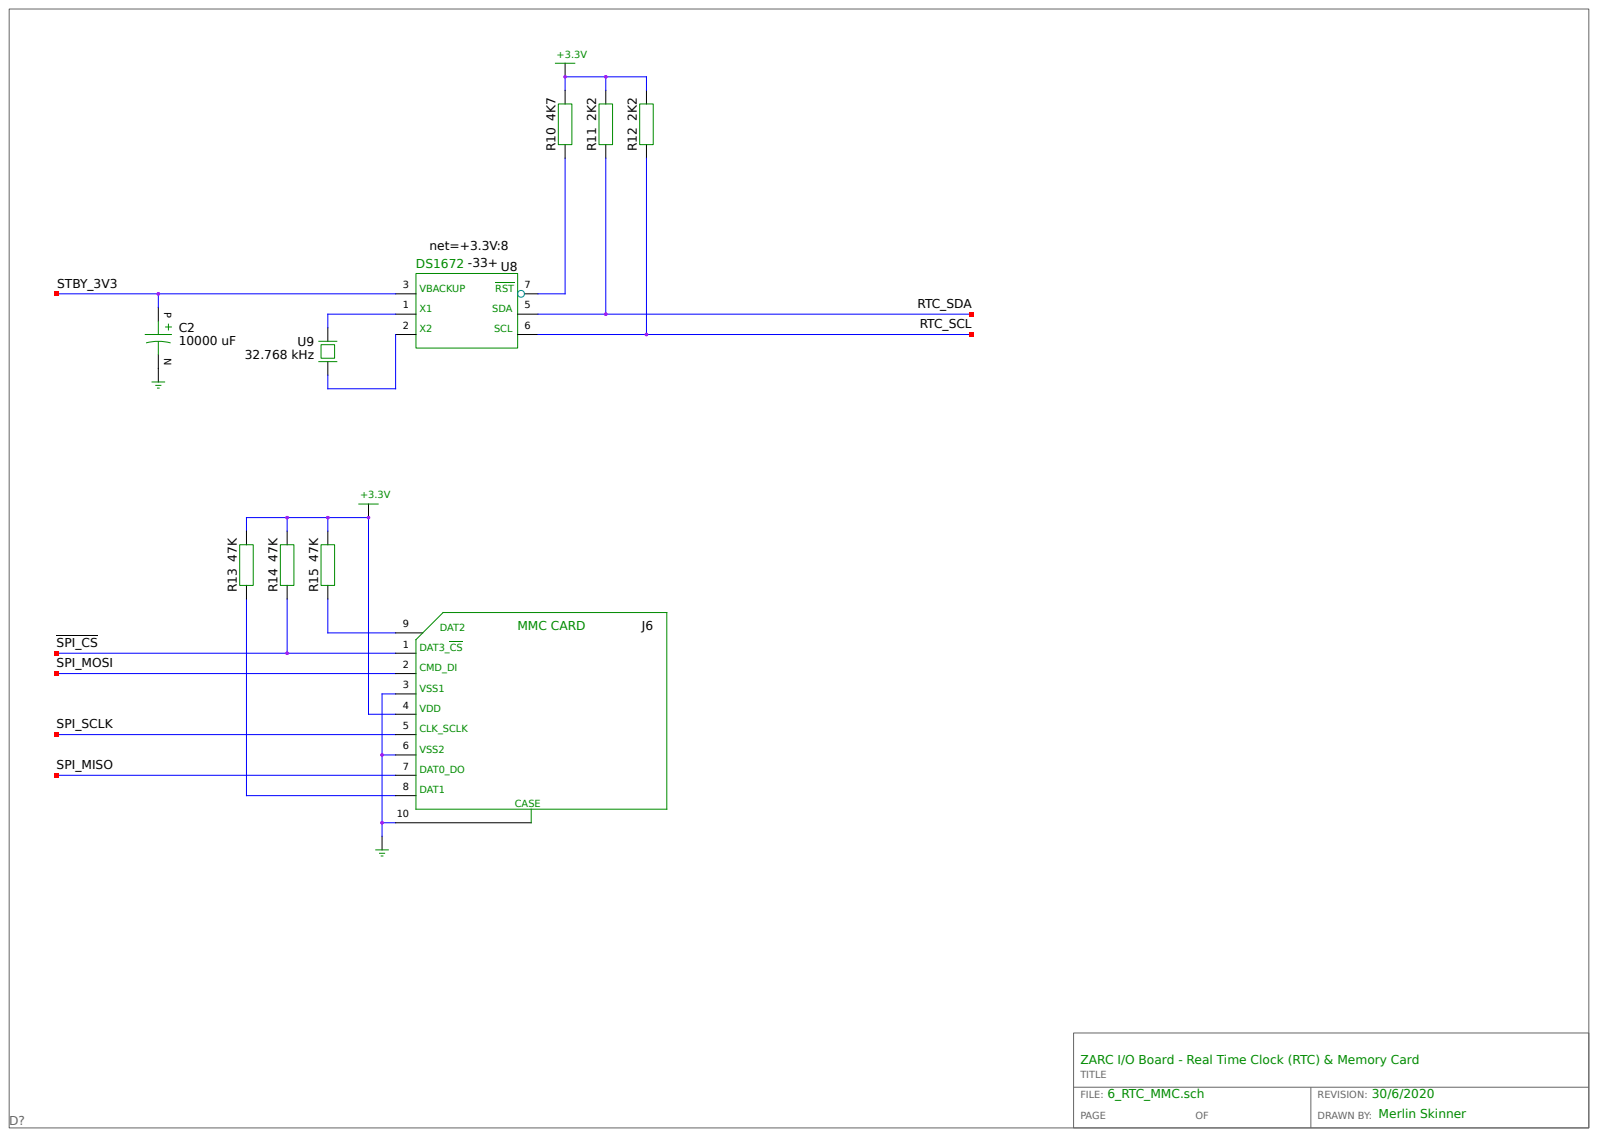
[picture p14: page 6]

ZARC I/O Board - Real Time Clock (RTC) & Memory Card
