rundel-tech/ZARC/hardware/CAD/Main/Output/Schematics.pdf

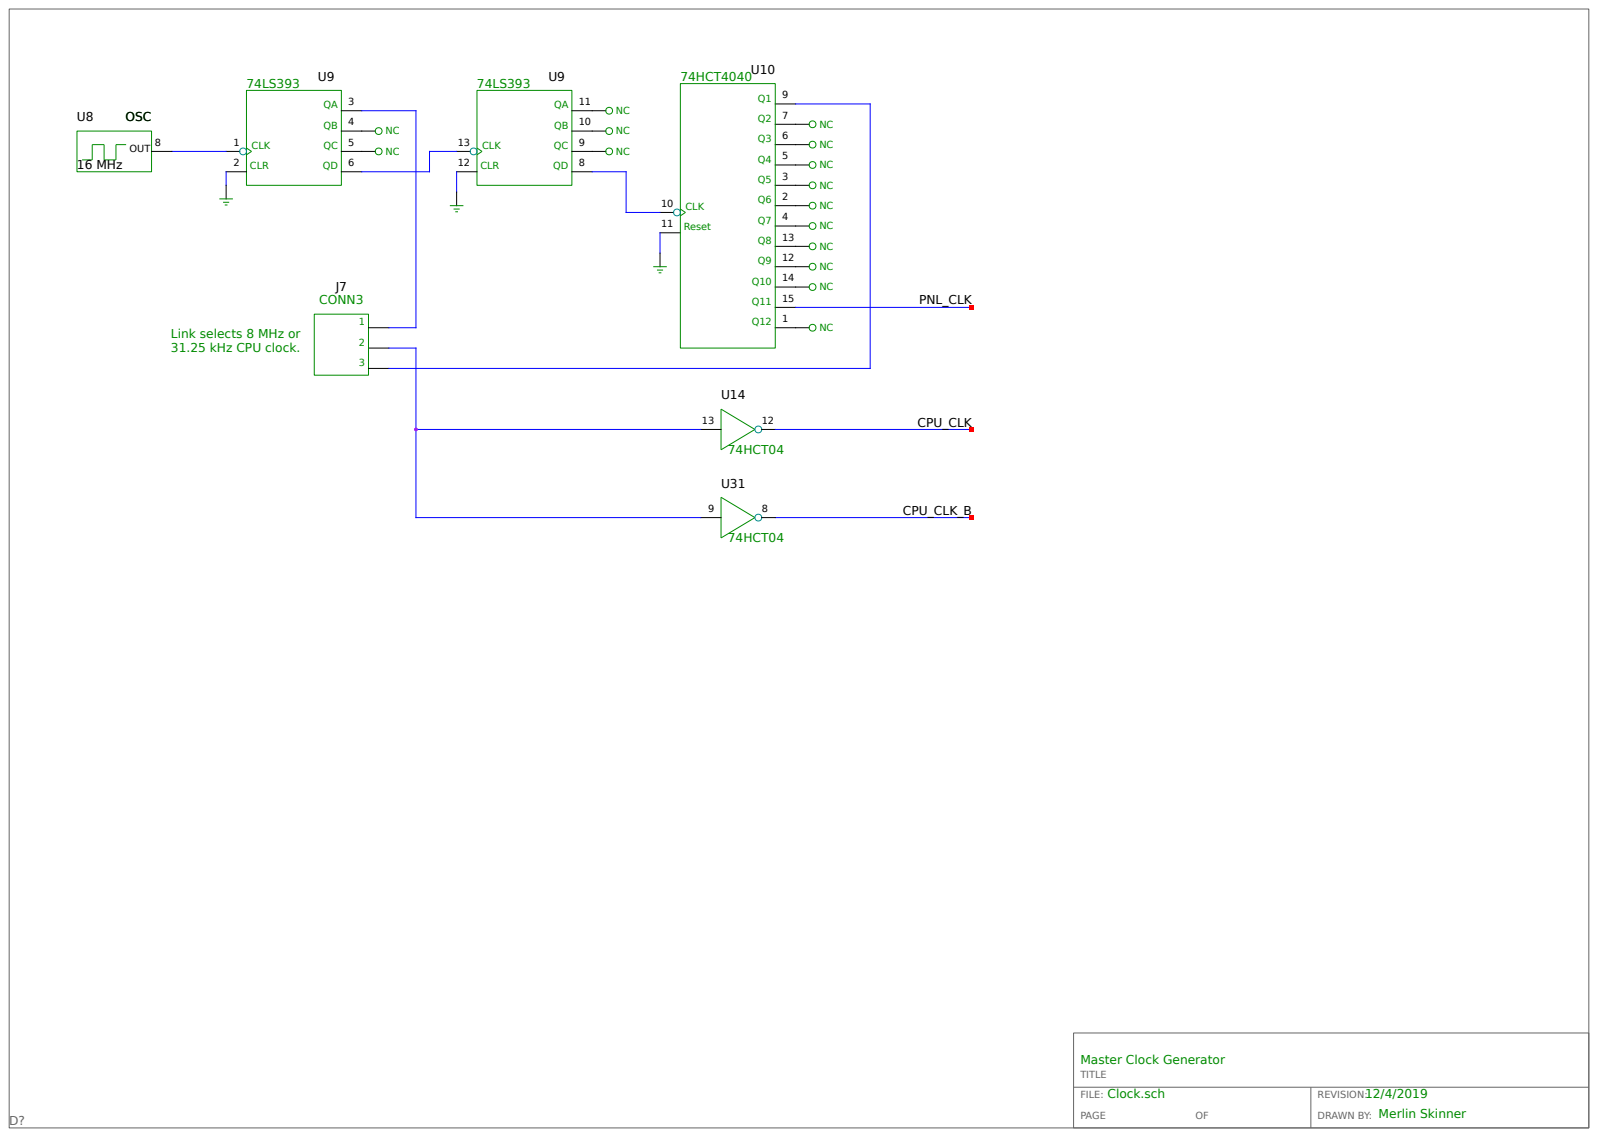
[picture p15: page 1]

Link selects 8 MHz or
31.25 kHz CPU clock.

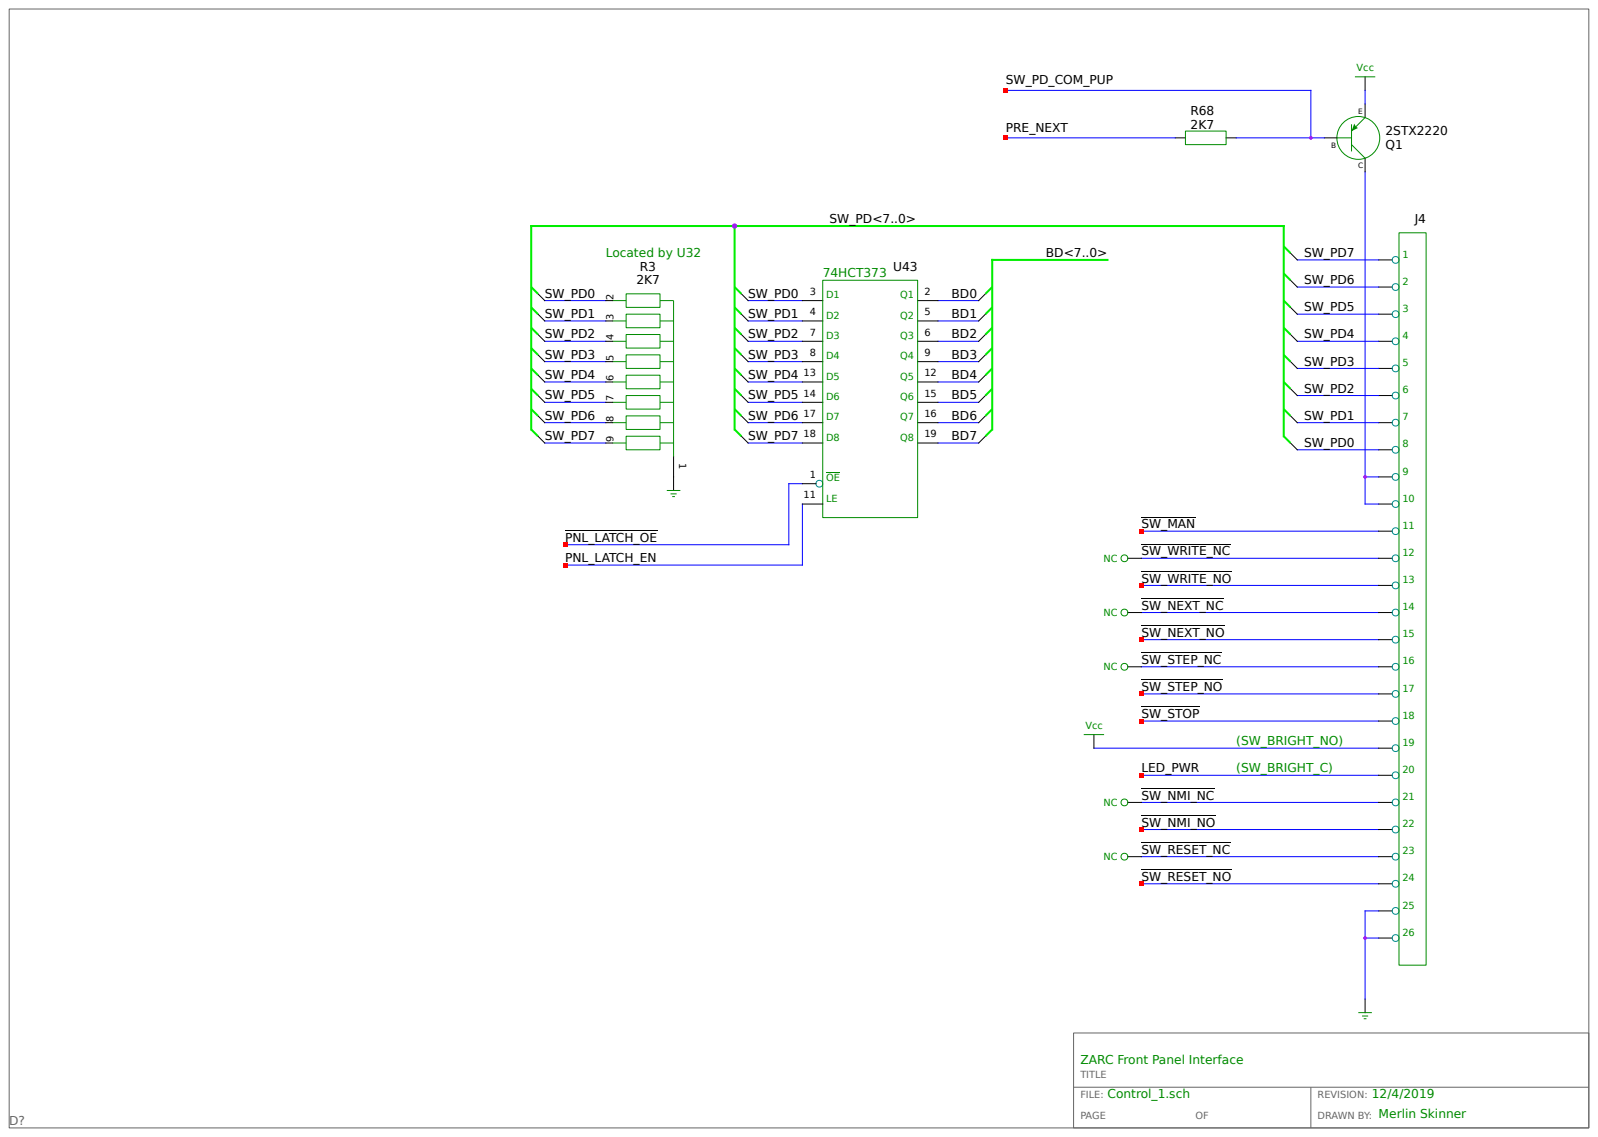
[picture p16: page 2]

ZARC Front Panel Interface

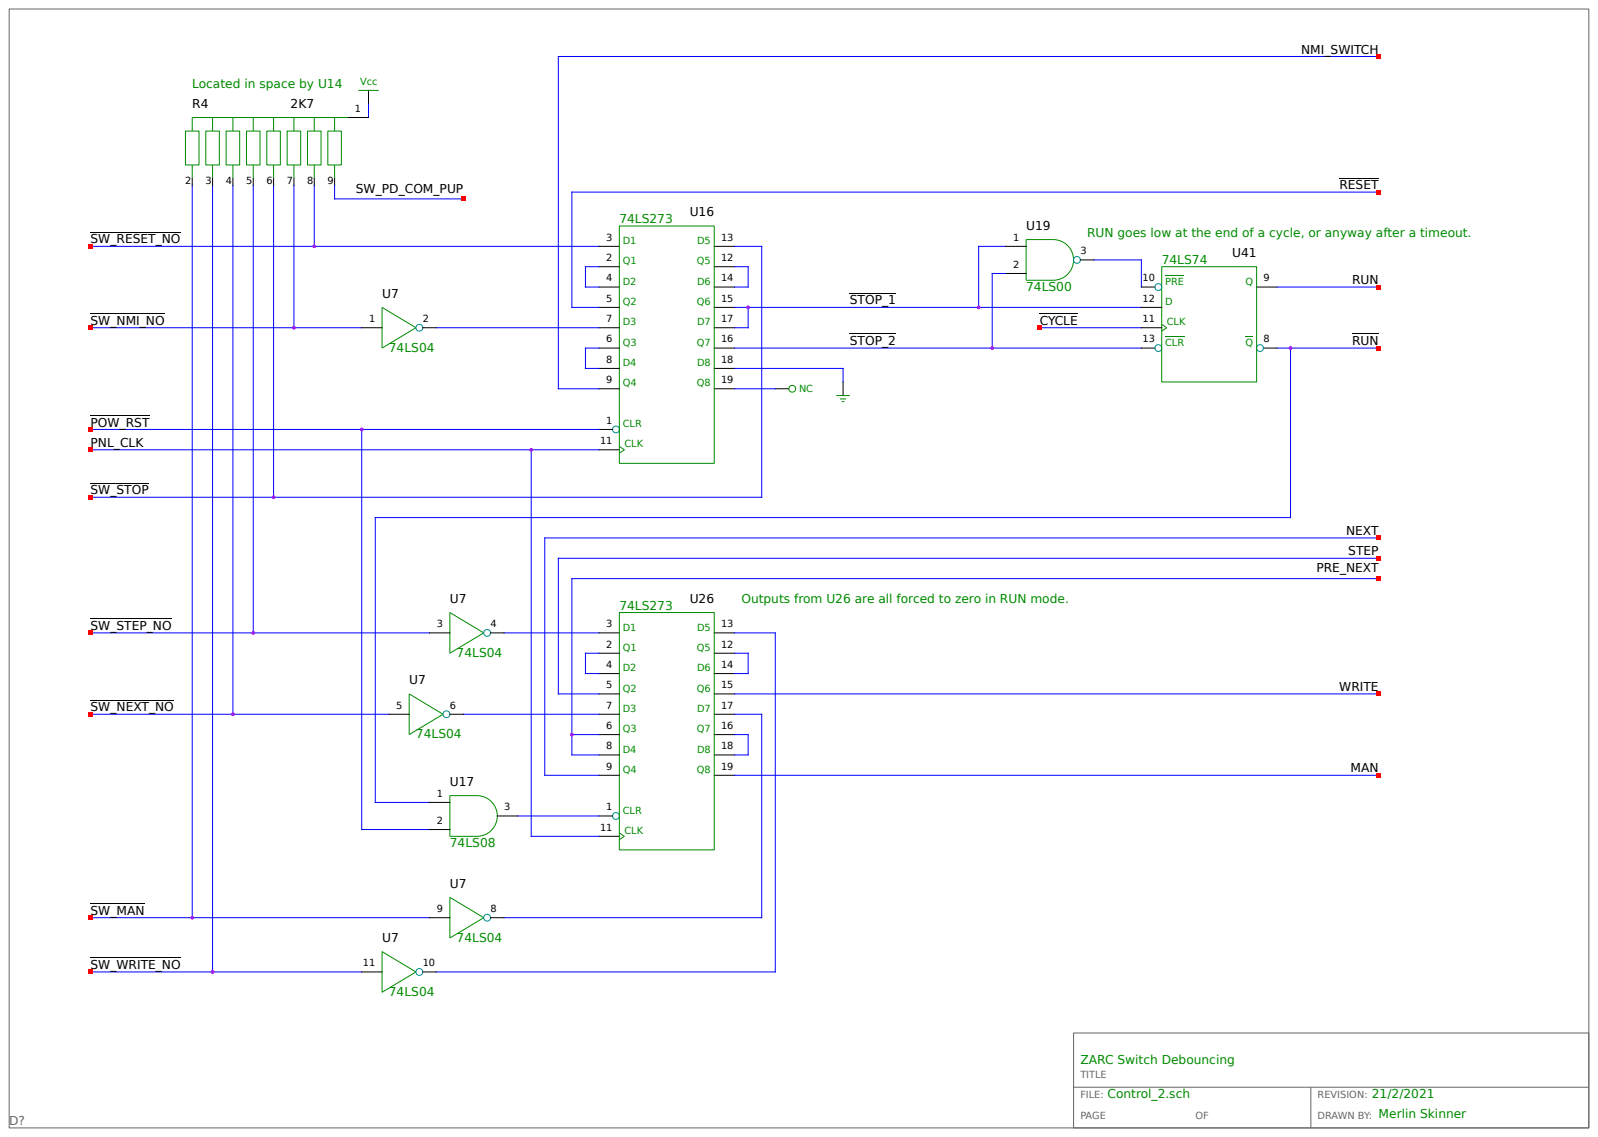
[picture p17: page 3]

RUN goes low at the end of a cycle, or anyway after a timeout.

Outputs from U26 are all forced to zero in RUN mode.

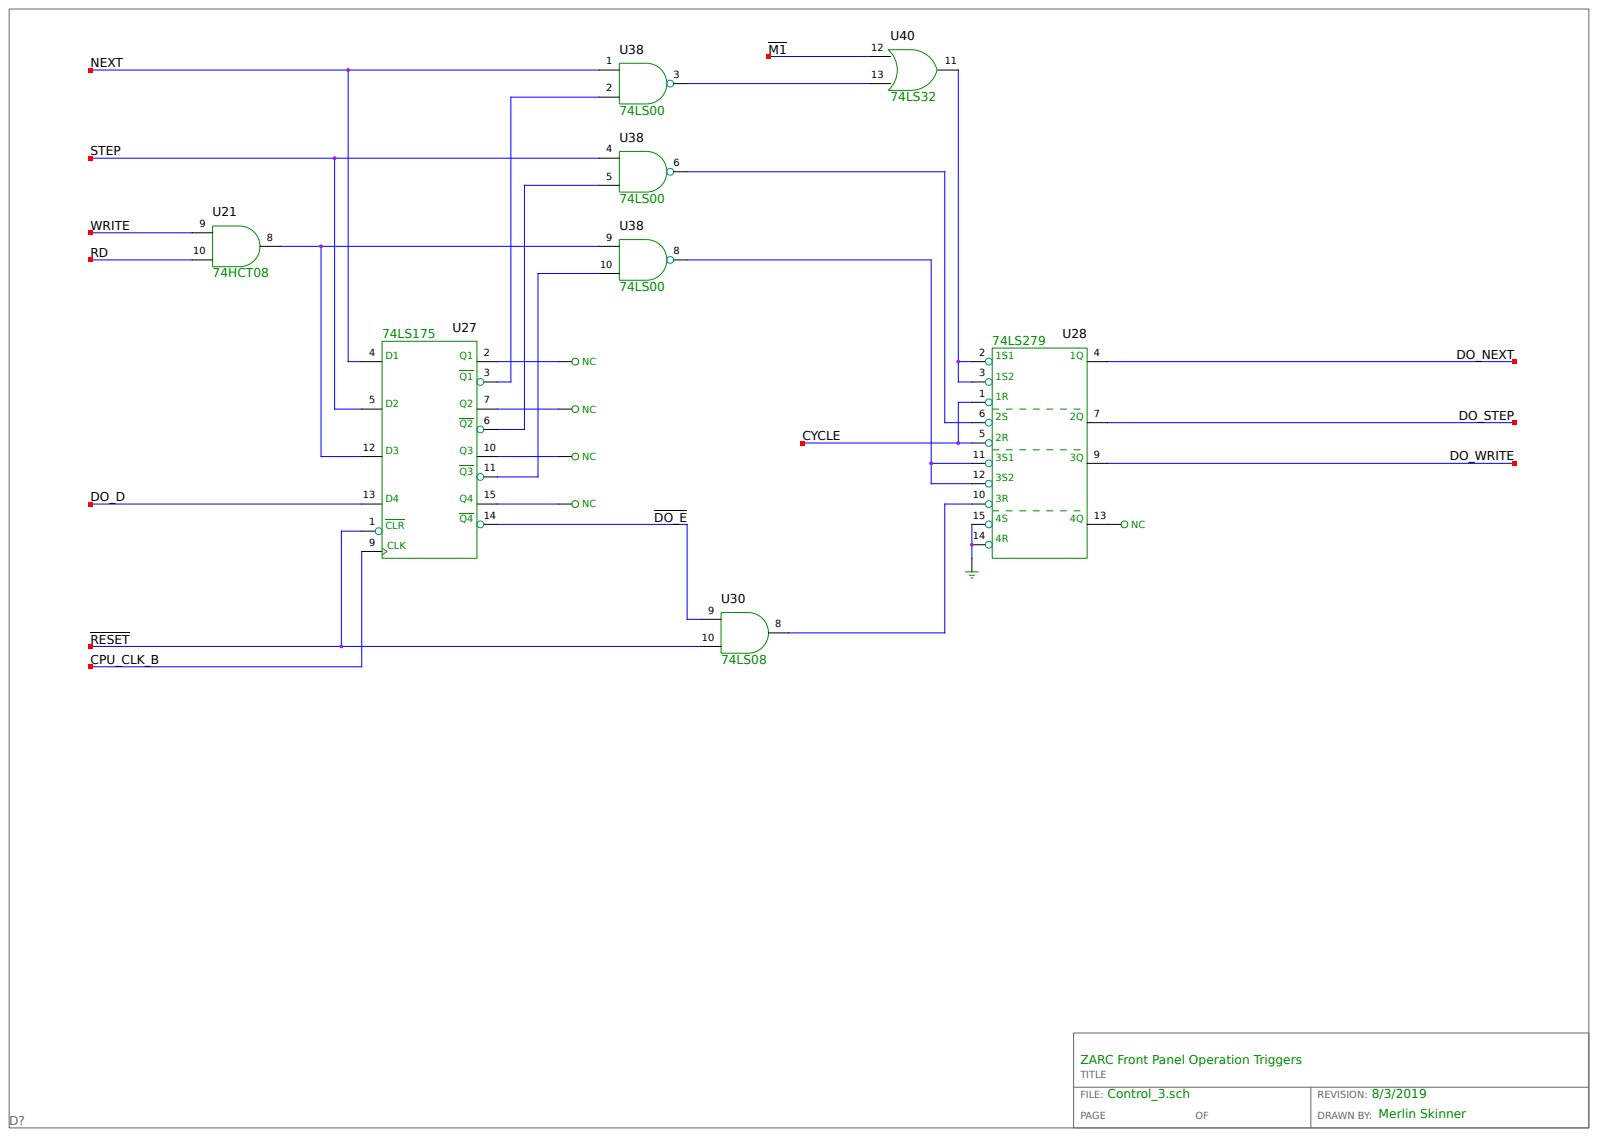
[picture p18: page 4]

ZARC Front Panel Operation Triggers

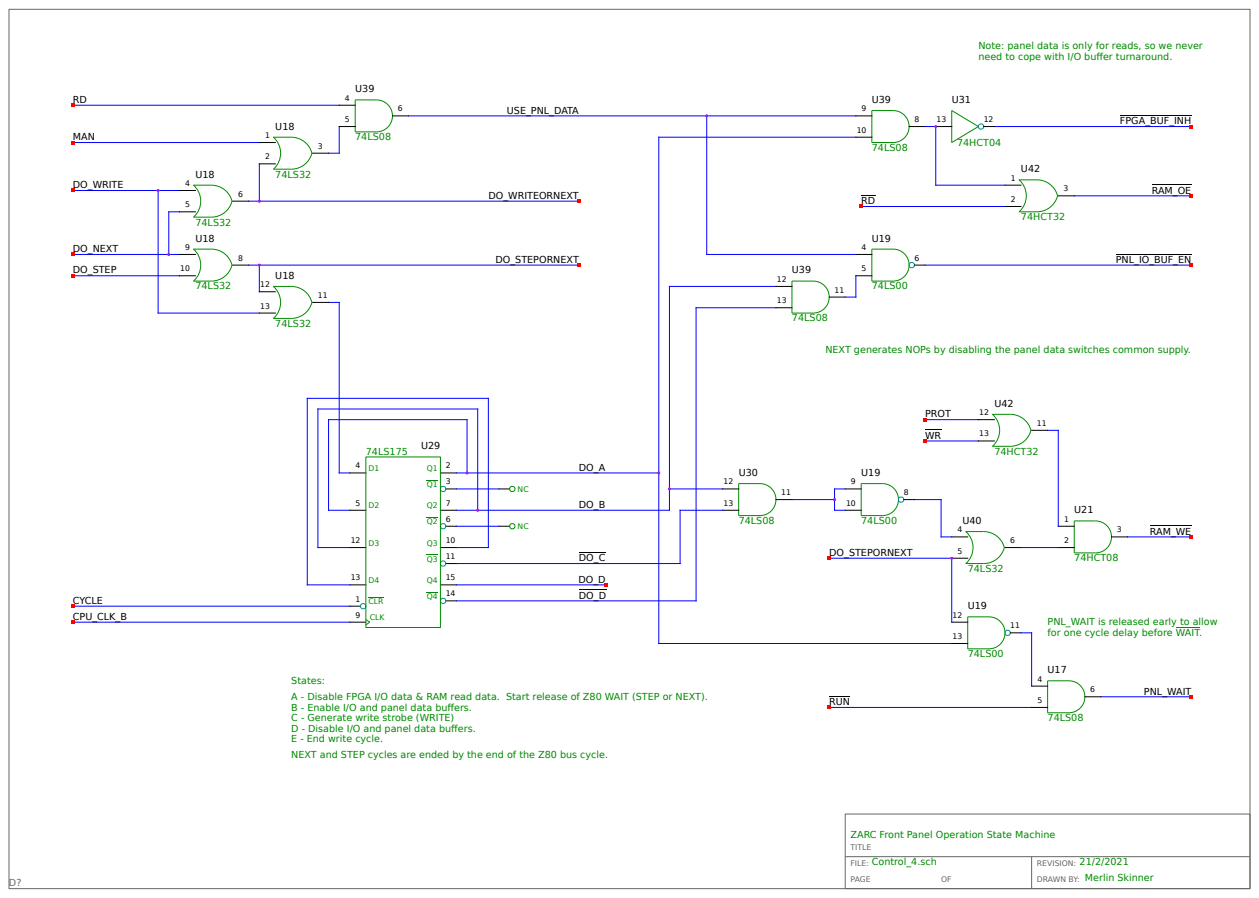
[picture p19: page 5]

Note: panel data is only for reads, so we never
need to cope with I/O buffer turnaround.

NEXT generates NOPs by disabling the panel data switches common supply.

PNL_WAIT is released early to allow
for one cycle delay before WAIT.

States:
A - Disable FPGA I/O data & RAM read data. Start release of Z80 WAIT (STEP or NEXT).
B - Enable I/O and panel data buffers.
C - Generate write strobe (WRITE)
D - Disable I/O and panel data buffers.
E - End write cycle.
NEXT and STEP cycles are ended by the end of the Z80 bus cycle.

ZARC Front Panel Operation State Machine

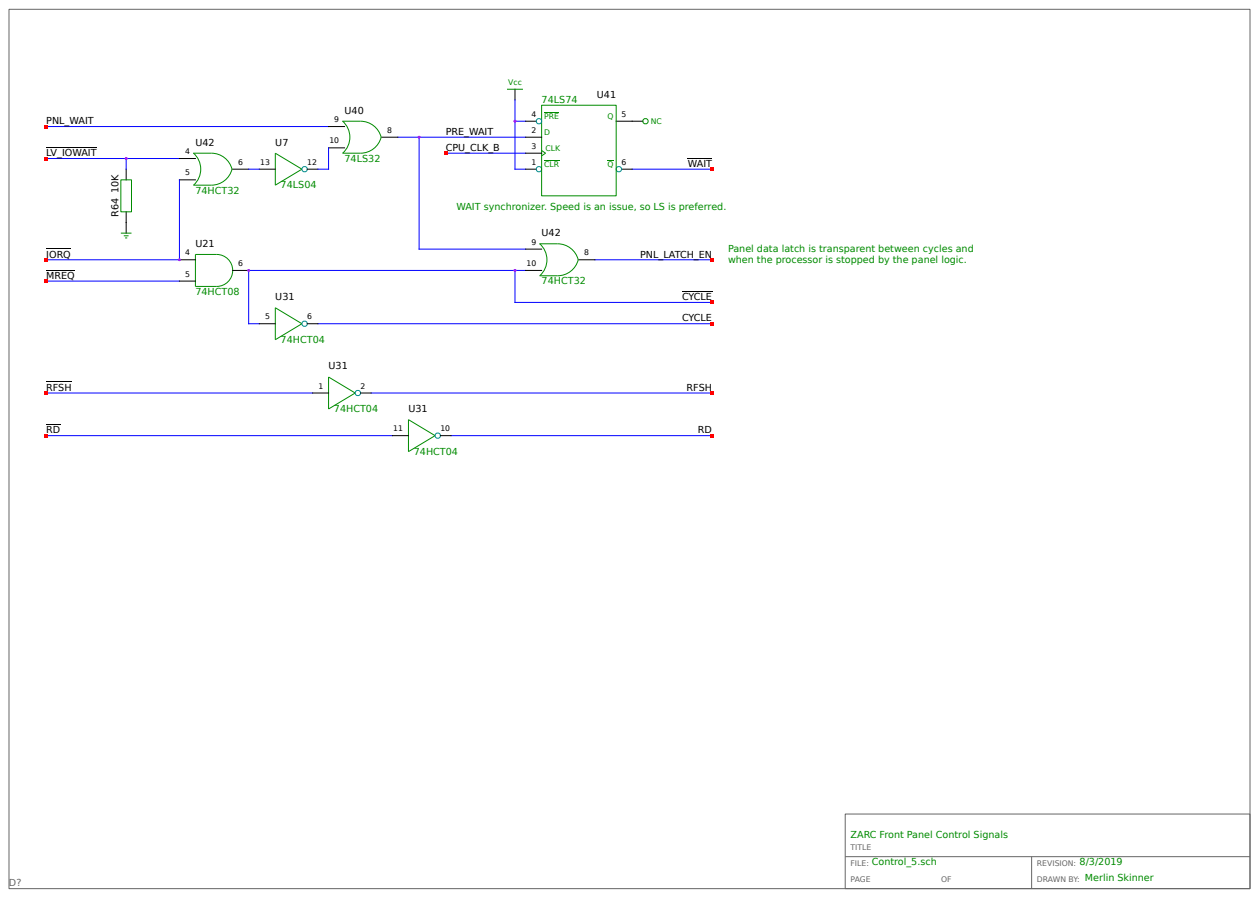
[picture p20: page 6]
RFSH; Control_5.sch; LV_IOWAIT; IORQ; PNL_WAIT; CPU_CLK_B; WAIT; Vcc; PRE_WAIT; MREQ; CYCLE; 1 CLR; 4 PRE; 3 CLK; PNL_LATCH_EN; Panel data latch is transparent between cycles and; 74HCT04; 74HCT32; 74HCT08

WAIT synchronizer. Speed is an issue, so LS is preferred.

when the processor is stopped by the panel logic.

ZARC Front Panel Control Signals

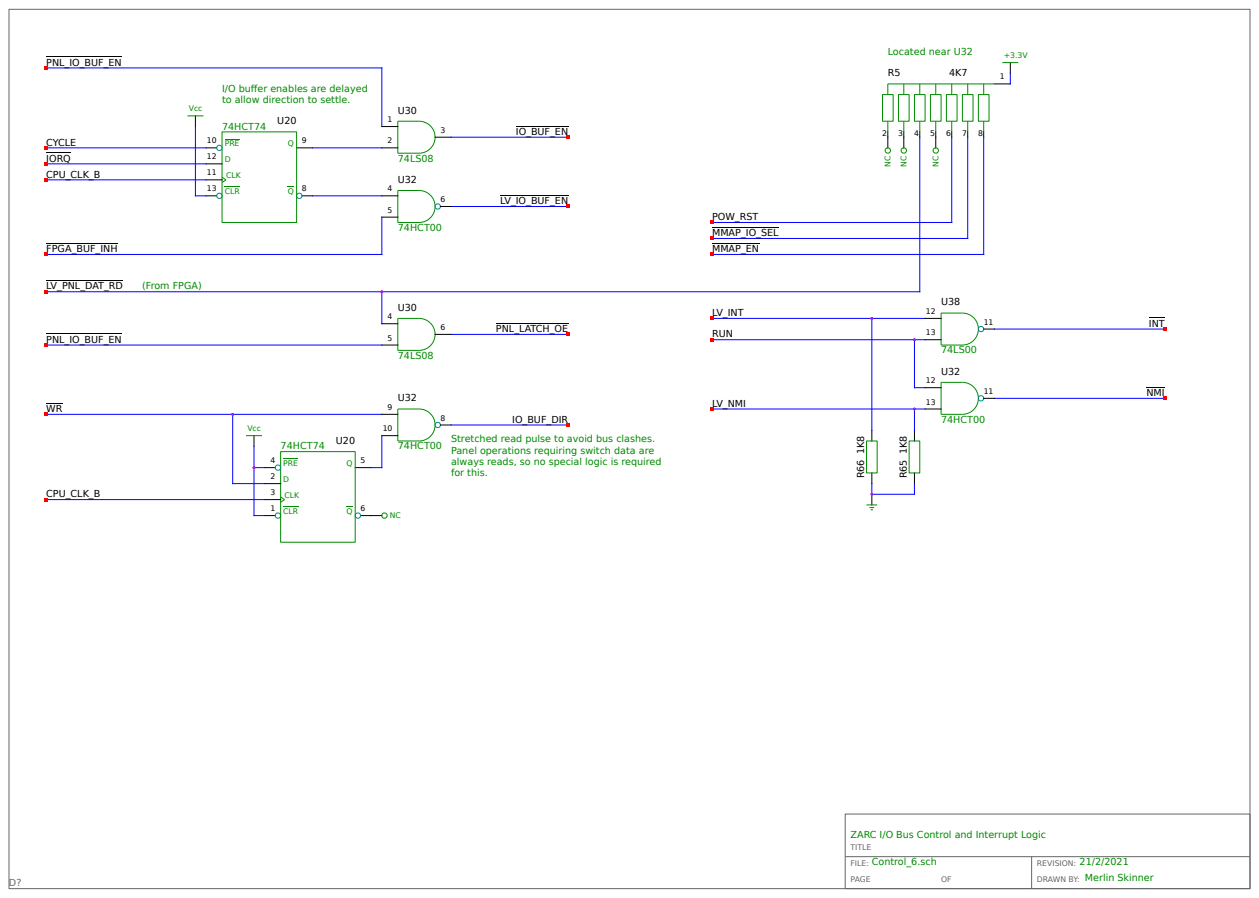
[picture p21: page 7]
Control_6.sch; IORQ; LV_IO_BUF_EN; IO_BUF_DIR; IO_BUF_EN; CYCLE; PNL_LATCH_OE; LV_PNL_DAT_RD; (From FPGA); 1 CLR; 4 PRE; 3 CLK; 74HCT74 U20; CPU_CLK_B; Vcc; 13 CLR; 10 PRE; 11 CLK; PNL_IO_BUF_EN; FPGA_BUF_INH; LV_INT; RUN; LV_NMI; INT; NMI; POW_RST; MMAP_IO_SEL MMAP_EN; 74HCT00; Located near U32

I/O buffer enables are delayed
to allow direction to settle.

Stretched read pulse to avoid bus clashes.
Panel operations requiring switch data are
always reads, so no special logic is required
for this.

ZARC I/O Bus Control and Interrupt Logic

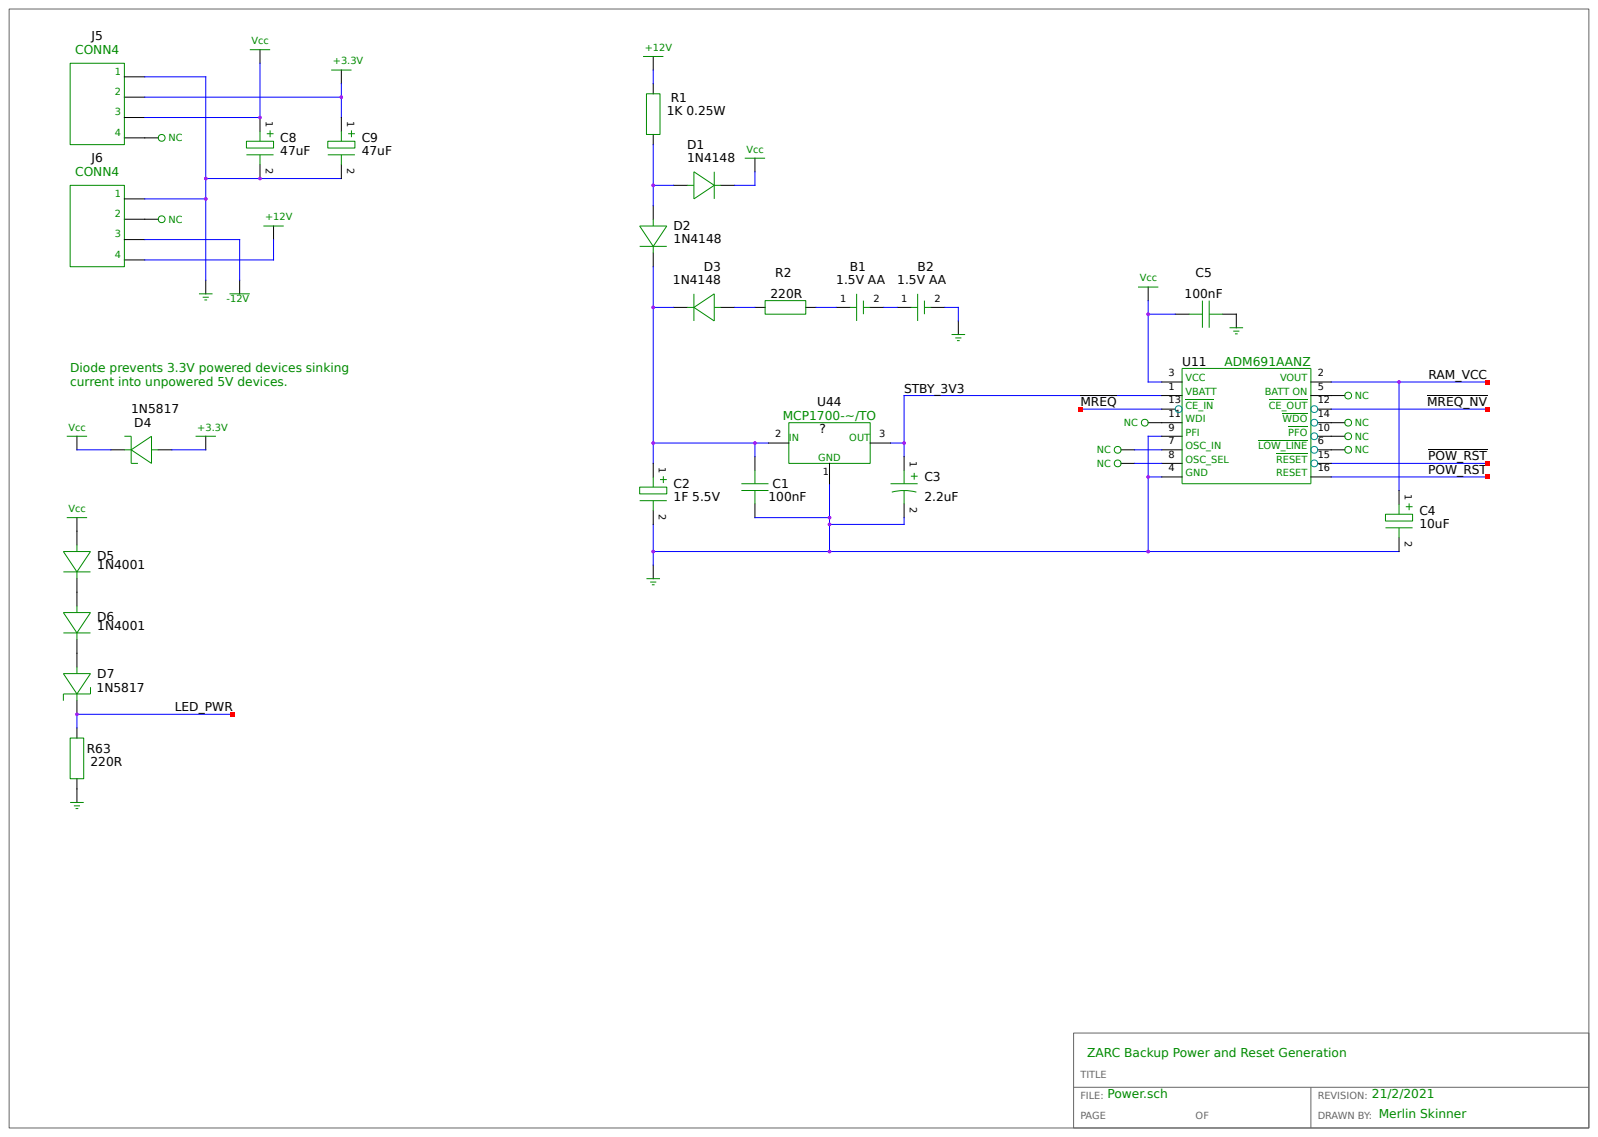
[picture p22: page 8]

Diode prevents 3.3V powered devices sinking
current into unpowered 5V devices.

ZARC Backup Power and Reset Generation

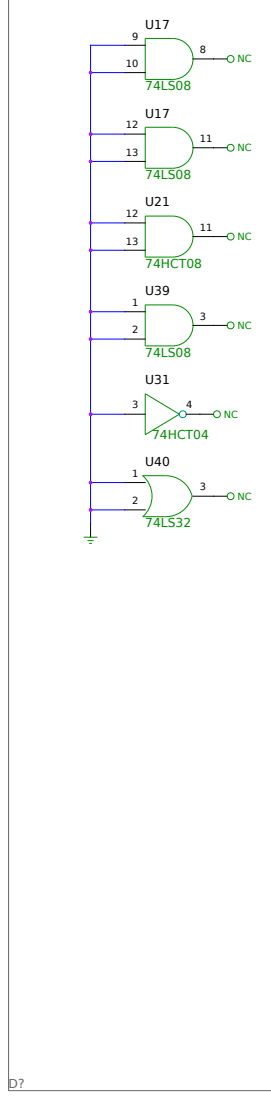
[picture p23: page 9]
Spare Gates; Spares.sch; 74HCT08; 74HCT04

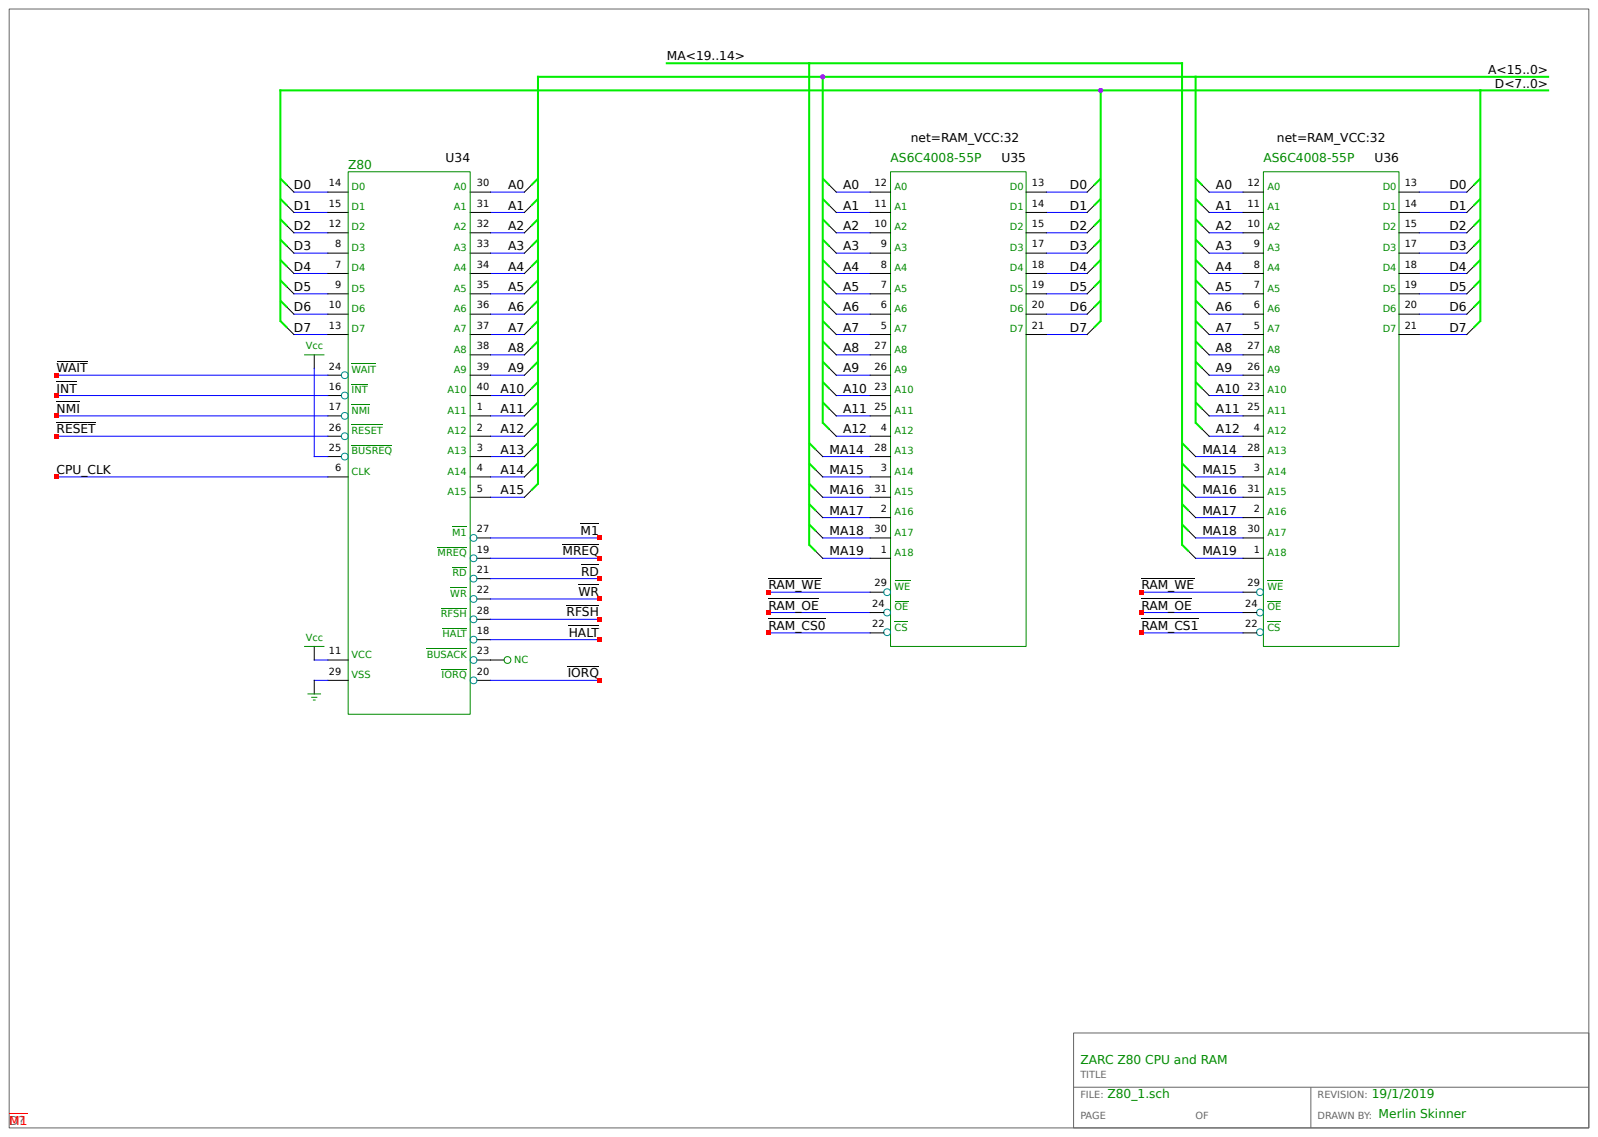
[picture p24: page 10]

ZARC Z80 CPU and RAM

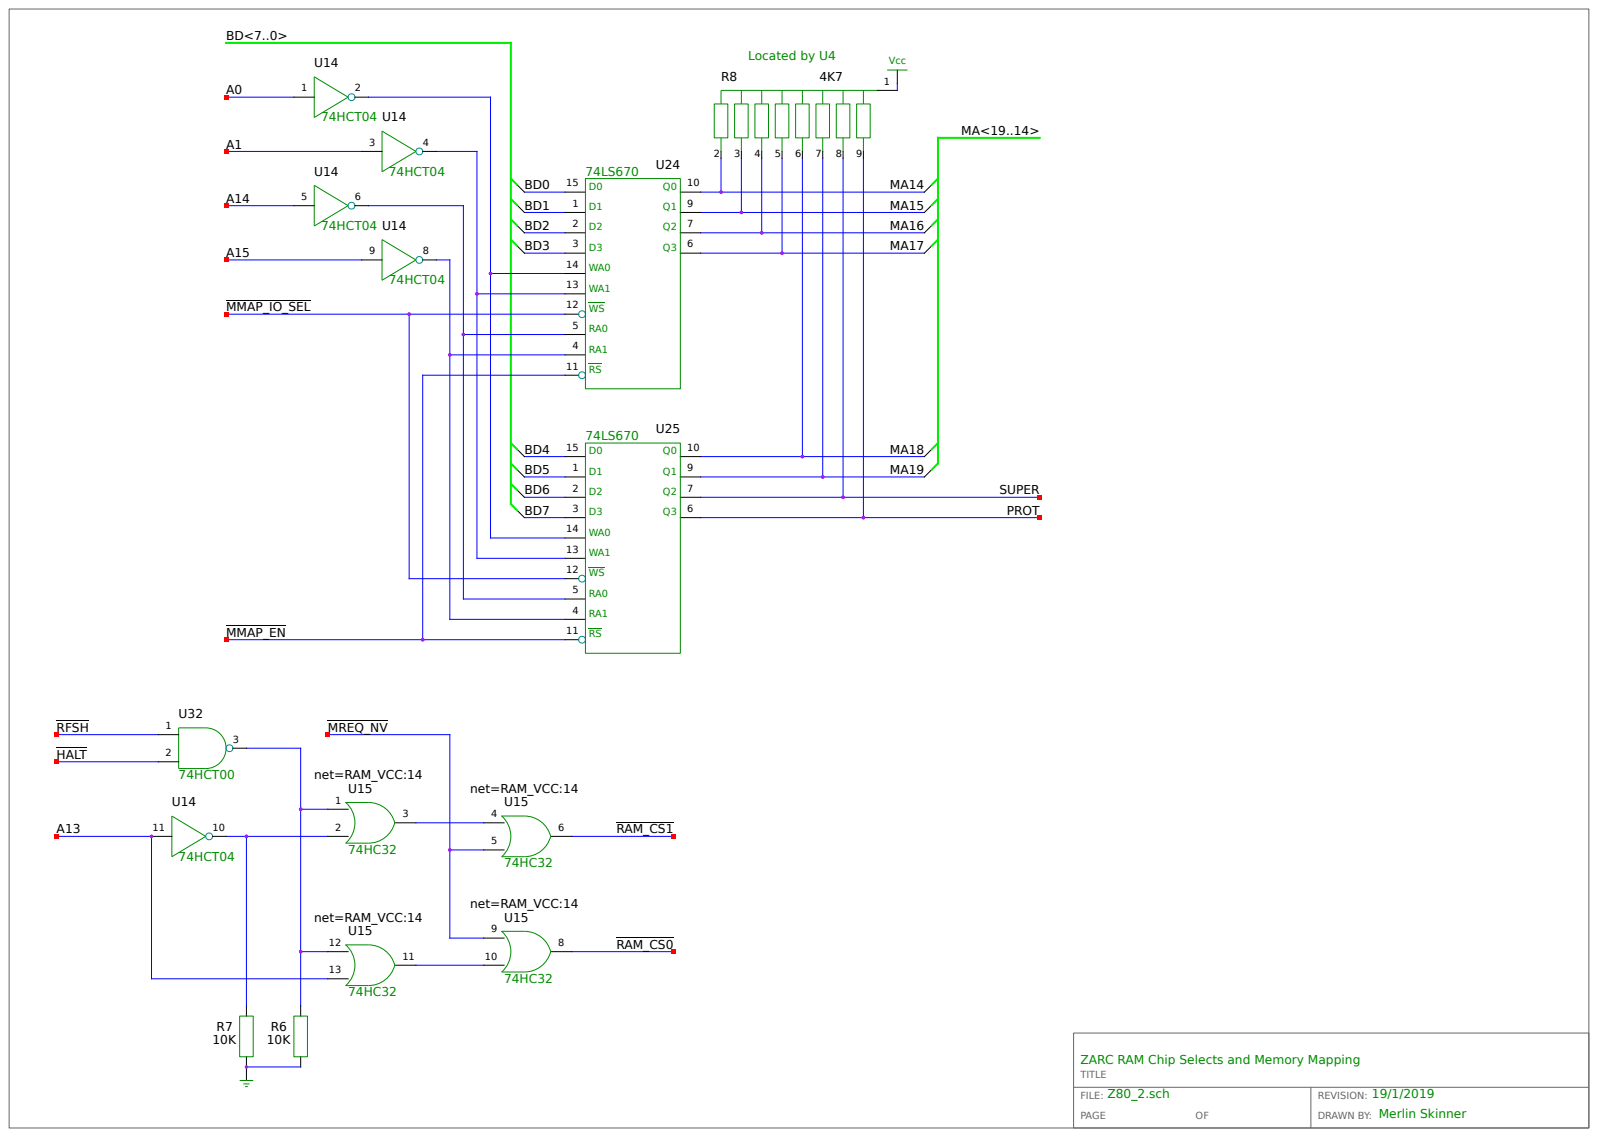
[picture p25: page 11]

ZARC RAM Chip Selects and Memory Mapping

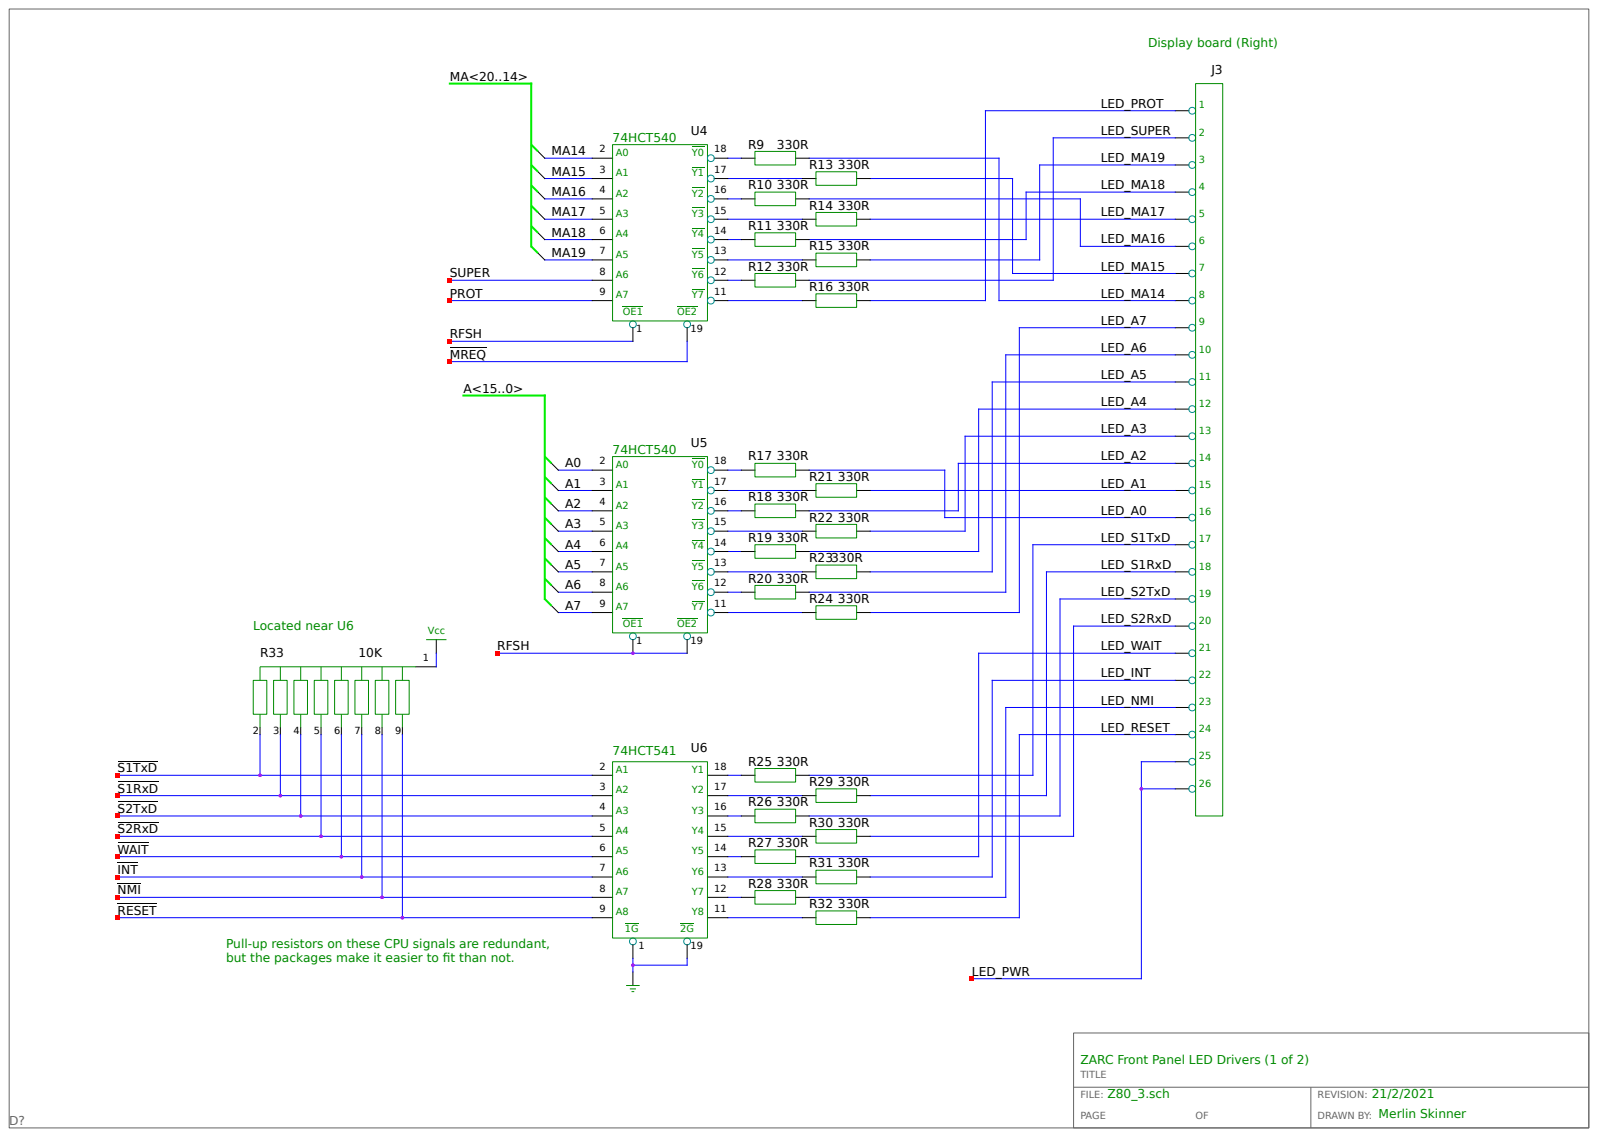
[picture p26: page 12]

Pull-up resistors on these CPU signals are redundant,
but the packages make it easier to fit than not.

ZARC Front Panel LED Drivers (1 of 2)

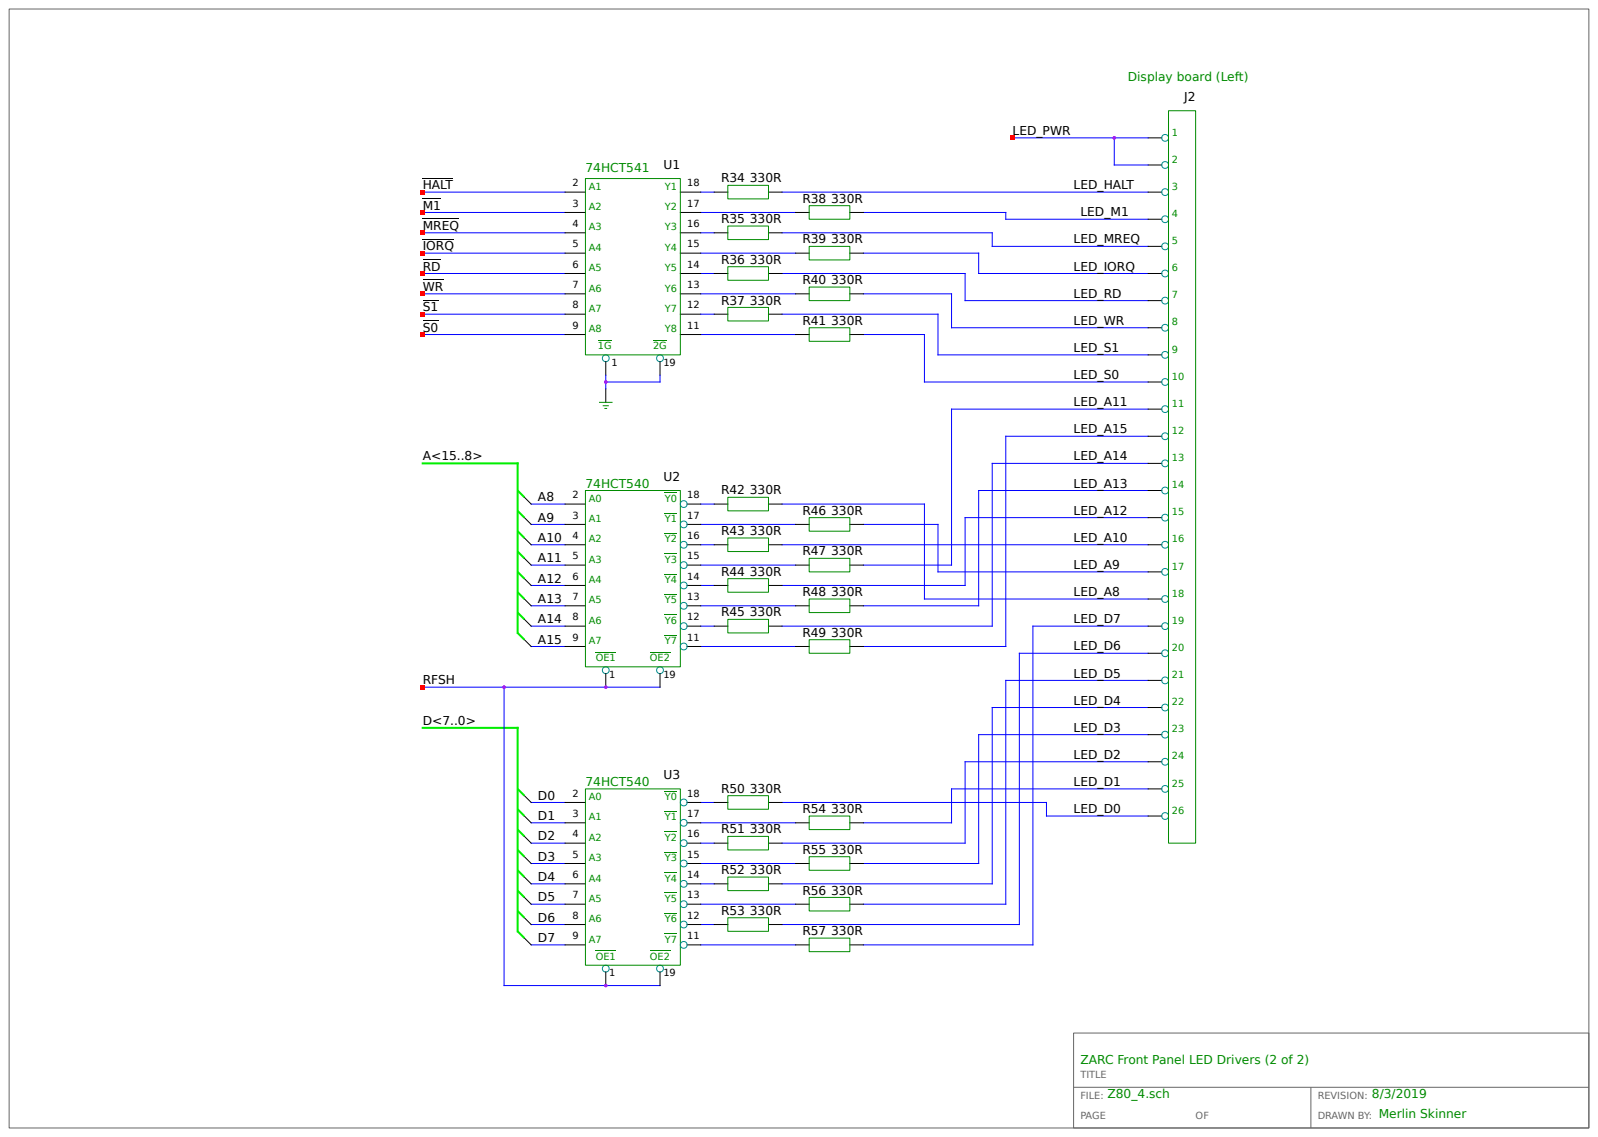
[picture p27: page 13]

ZARC Front Panel LED Drivers (2 of 2)

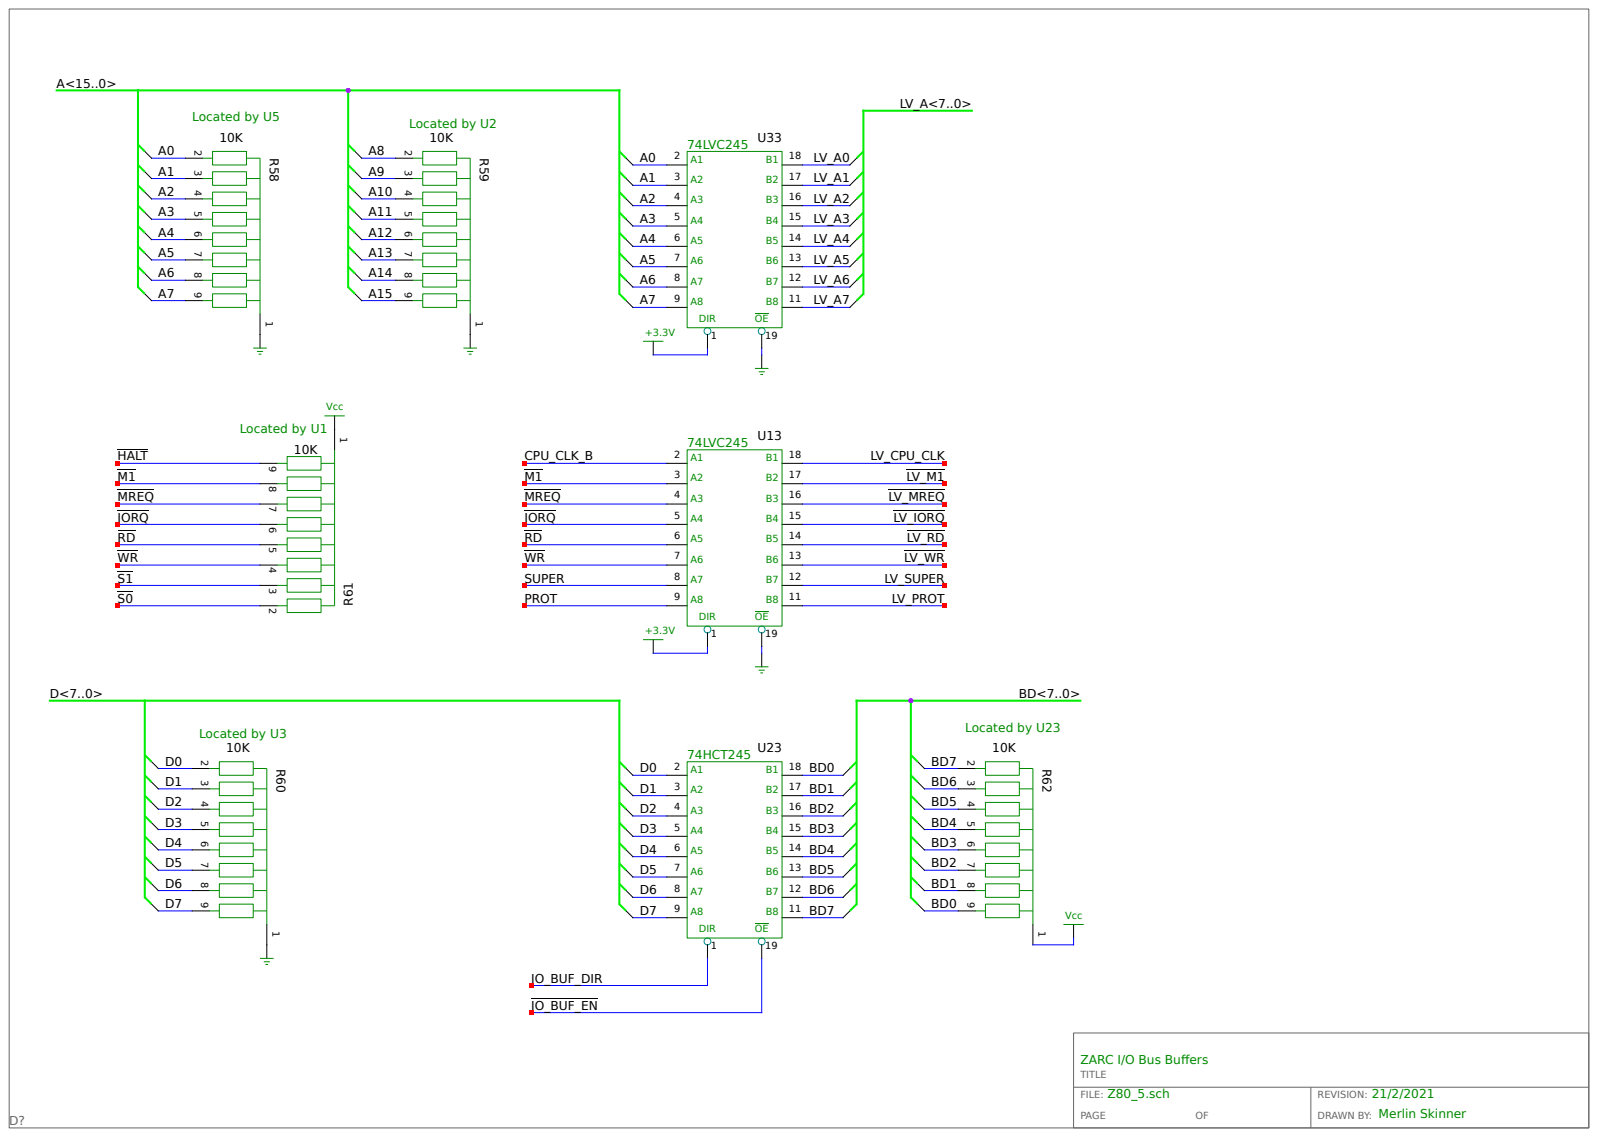
[picture p28: page 14]

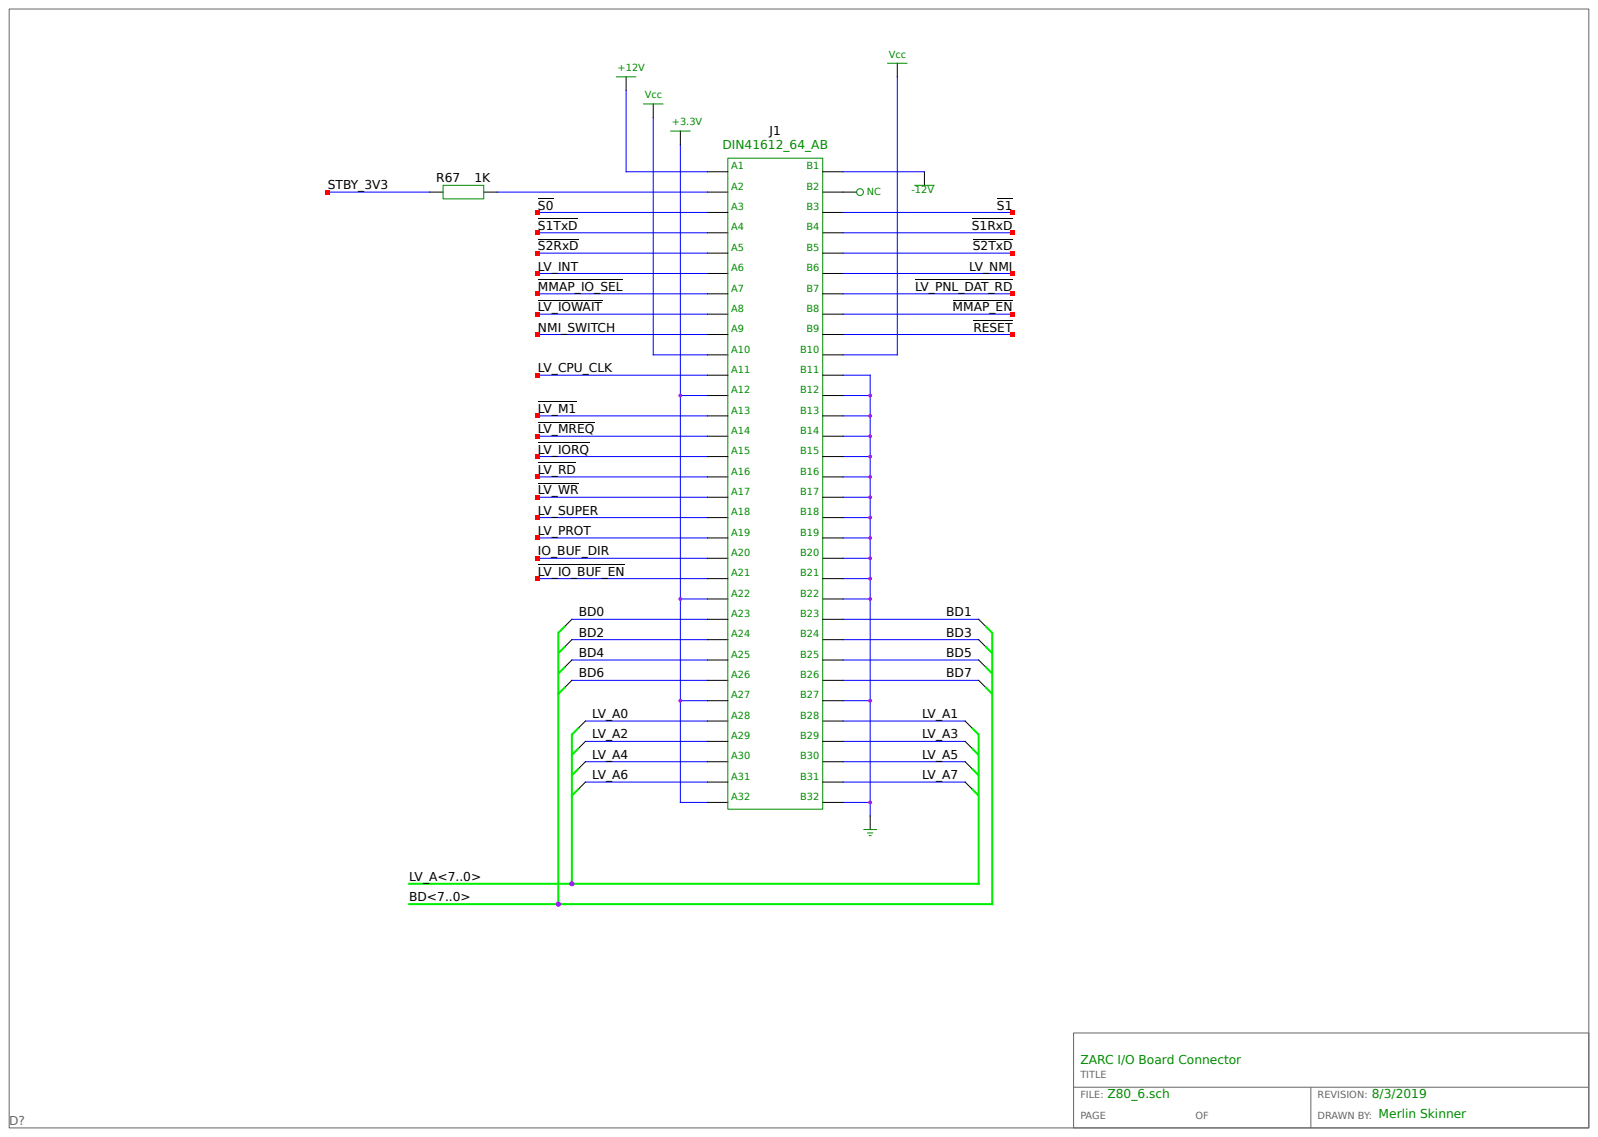
[picture p29: page 15]
Z80_6.sch; LV_IO_BUF_EN; LV_CPU_CLK; LV_MREQ LV_IORQ LV_RD LV_WR LV_SUPER LV_PROT IO_BUF_DIR; Vcc; NMI_SWITCH; RESET; LV_IOWAIT; MMAP_IO_SEL; MMAP_EN; DIN41612_64_AB; S1TxD S2RxD; LV_PNL_DAT_RD; LV_INT; LV_NMI; S1RxD S2TxD; R67 1K STBY_3V3

ZARC I/O Board Connector
