rundel-tech/ZARC/hardware/CAD/Panel/Output/Schematics.pdf

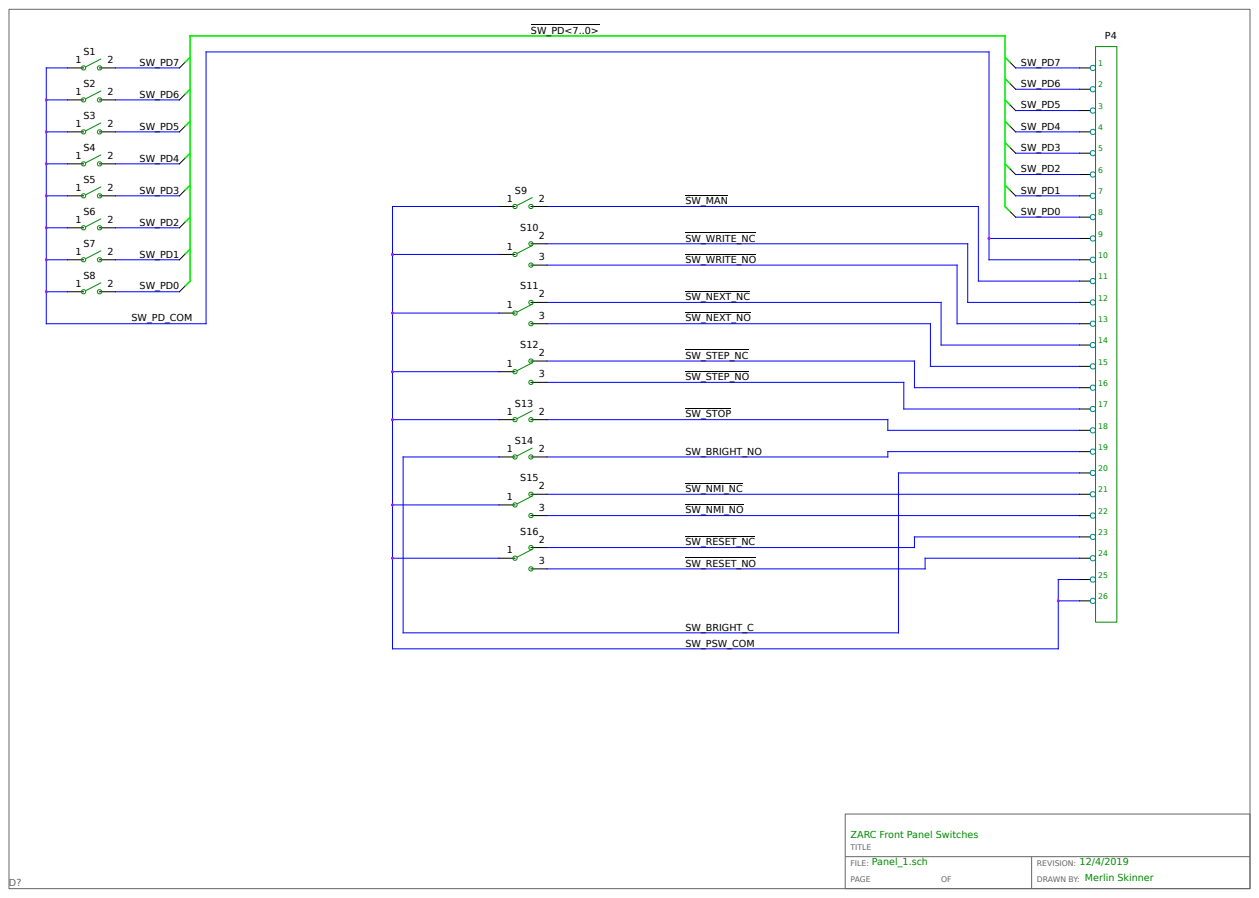
[picture p30: page 1]
FILE:; REVISION:; PAGE; DRAWN BY:; 12/4/2019 Merlin Skinner; SW_PD_COM; SW_PSW_COM; SW_MAN; SW_STOP; SW_BRIGHT_NO; SW_BRIGHT_C; SW_WRITE_NC; SW_WRITE_NO; SW_NEXT_NC; SW_NEXT_NO; SW_STEP_NC; SW_STEP_NO; SW_NMI_NC; SW_NMI_NO; SW_RESET_NC; SW_RESET_NO

ZARC Front Panel Switches
TITLE
Panel_1.sch

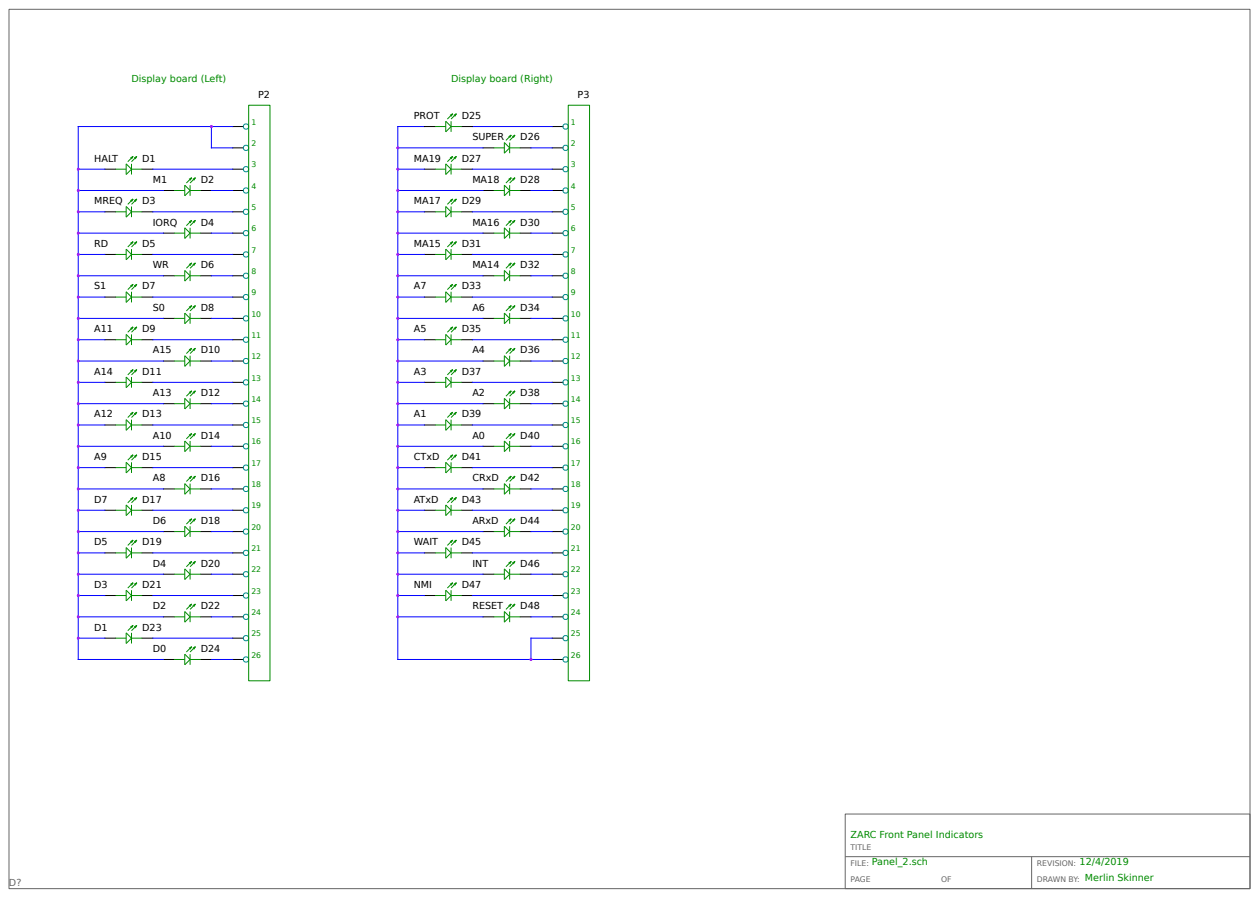
[picture p31: page 2]
FILE:; REVISION:; PAGE; DRAWN BY:; 12/4/2019 Merlin Skinner; D1HALT; D3MREQ; D4IORQ; D41CTxD; D42CRxD; D43ATxD; D44ARxD; D45WAIT; D46INT; D47NMI; D48RESET; D26SUPER; D25PROT

Display board (Left)

Display board (Right)

ZARC Front Panel Indicators
TITLE
Panel_2.sch
