rundel-tech/ZARC/(commit log)

2022-11-04 Added /s option to fsck
    [call_freq.ods]
2023-06-13 Support interleaved discs by calling SECTRAN before SETSEC
    This is at least part of the fix for Issue #2
    With this change, the filenames and user numbers are found correctly, but each
    file reports "block number out of range".
    [from track 2 sector 1]
    U0 MOVCPM .COM - block number out of range
    U0 PIP .COM - block number out of range
    U0 SUBMIT .COM - block number out of range
    U0 XSUB .COM - block number out of range
    [from track 2 sector 7]
    U0 ED .COM - block number out of range
    U0 ASM .COM - block number out of range
    U0 DDT-ORIG.COM - block number out of range
    U0 LOAD .COM - block number out of range
    [etc]
2023-06-14 Fix small filesystems that use one-byte block numbers
    This change was suggested by Merlin in the Issue #2 thread.
